Lifearafter/CASE/README.md

# C.A.S.E

Welcome to the Compact Antenna Experimenter System Project repository! This project focuses on providing the necessary code and documentation to create a fully functional and electrically viable CubeSat. In this repository, you will find the software and firmware that drive the electrical components of a CubeSat, ensuring its proper functionality in space.

## Table of Contents

- Introduction
- Getting Started
- Project Structure
- Dependencies
- Contributing
- License

## Introduction

CubeSats are miniaturized satellites that have become increasingly popular for space exploration and scientific research due to their small size, cost-effectiveness, and modular design. This project focuses specifically on the electrical aspects of a CubeSat, excluding any mechanical components.

The key objectives of this project include:

- **Power Management:** Efficiently manage power resources to ensure the CubeSat's continuous operation in space.

- **Communication Systems:** Implement reliable communication protocols for data transmission between the CubeSat and ground control.

- **Sensor Integration:** Integrate and interface various sensors to gather data for scientific or mission-specific purposes.

- **Onboard Computer Systems:** Develop the necessary software for the CubeSat's onboard computer to execute mission tasks and handle data.

- **Fault Tolerance:** Implement mechanisms to handle errors and faults to ensure the CubeSat's robustness in harsh space environments.

## Getting Started

To get started with the CubeSatellite Electrical System Project, follow these steps:

1. **Clone the Repository:**

```
bash
Copy code
git clone https://github.com/your-username/cubesatellite-electrical.git
```

2. **Navigate to the Project Directory:**

```
bash
Copy code
cd cubesatellite-electrical
```

## Explore the Code:

Review the codebase to understand the implementation details and structure.

## Set Up Development Environment:

Follow the instructions in the docs/setup.md document to set up your development environment.

## Contribute:

If you would like to contribute to the project, please follow the guidelines outlined in the Contributing section.

## Project Structure

The project is organized into the following directories:

- src: Contains the source code for the CubeSat's electrical systems.
- docs: Documentation files, including setup instructions and usage guidelines.
- tests: Test cases for ensuring the reliability and functionality of the code.
- inc: Contains all the header files for the project.

## Dependencies

Ensure that you have the following dependencies installed in your development environment:
**Not yet listed**

## License

This project is licensed under the MIT License. Feel free to use, modify, and distribute the code for your CubeSat projects.
