Lifearafter/CASE/docs/FactoryDefaults.md

# Factory Defaults
File to store the factory defaults for all devices used. This file is used as a reference.

## Device 1
### Neo-M8N
* Baudrate: 115200
