Lifearafter/CASE/Schematics/Flight_Computer/FC_PCB.png

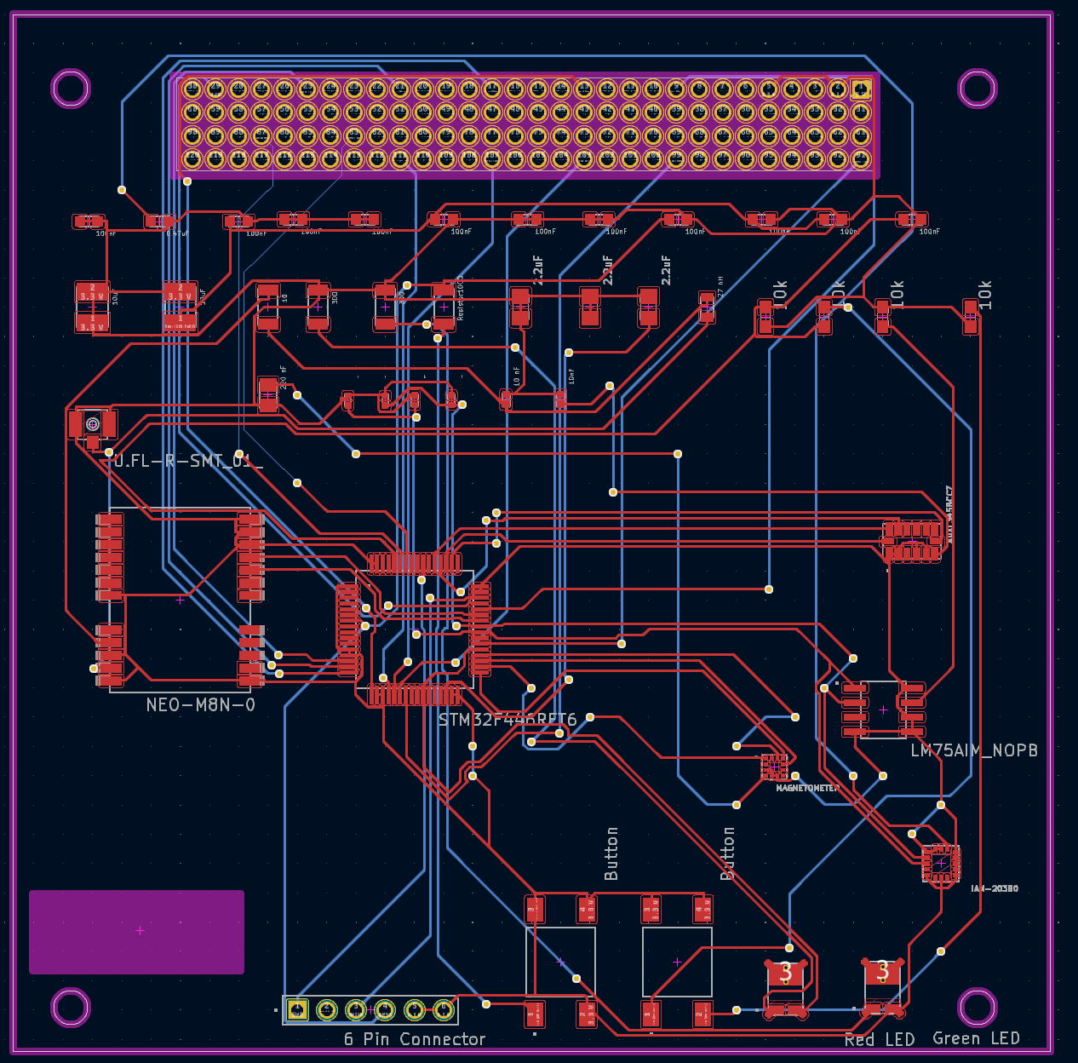
Schematics/Flight_Computer/FC_PCB.png
