Lifearafter/CASE/Schematics/Flight_Computer/FC_PCB_BLUE.png

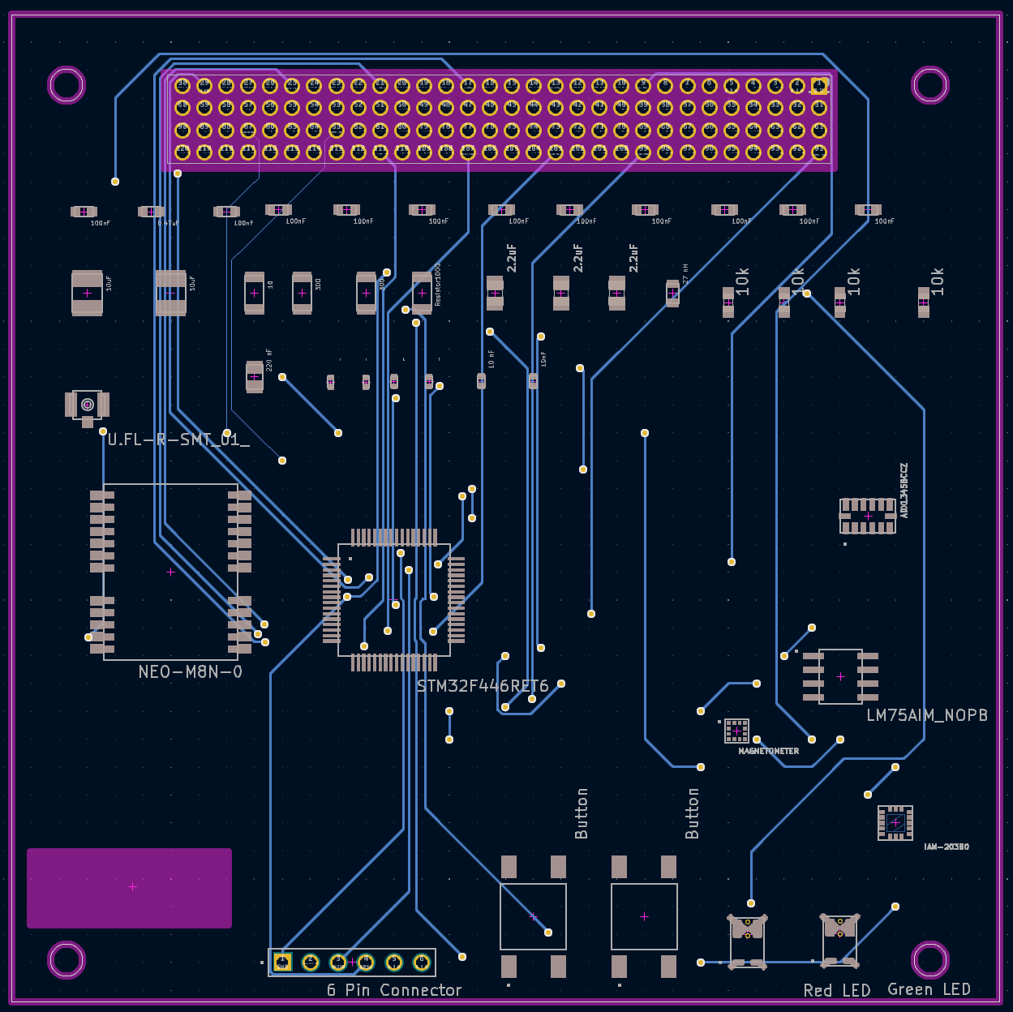
Schematics/Flight_Computer/FC_PCB_BLUE.png
