Lifearafter/CASE/Schematics/Flight_Computer/FC_PCB_RED.png

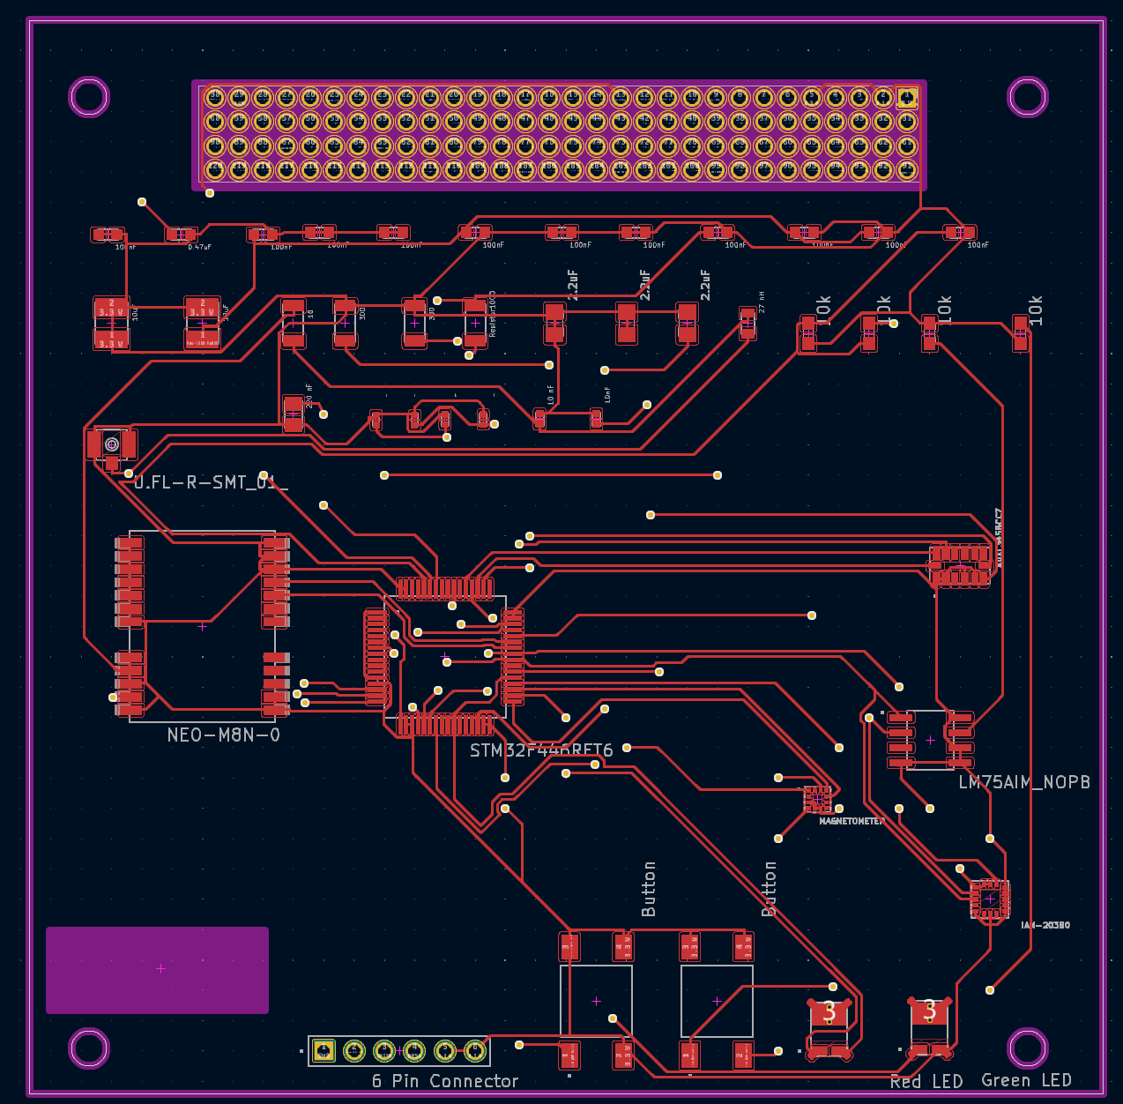
Schematics/Flight_Computer/FC_PCB_RED.png
