Lifearafter/CASE/Schematics/Comms_System/parts_backup/AC0402JRNPO9BN390/3D/AC0402JRNPO9BN390.stp

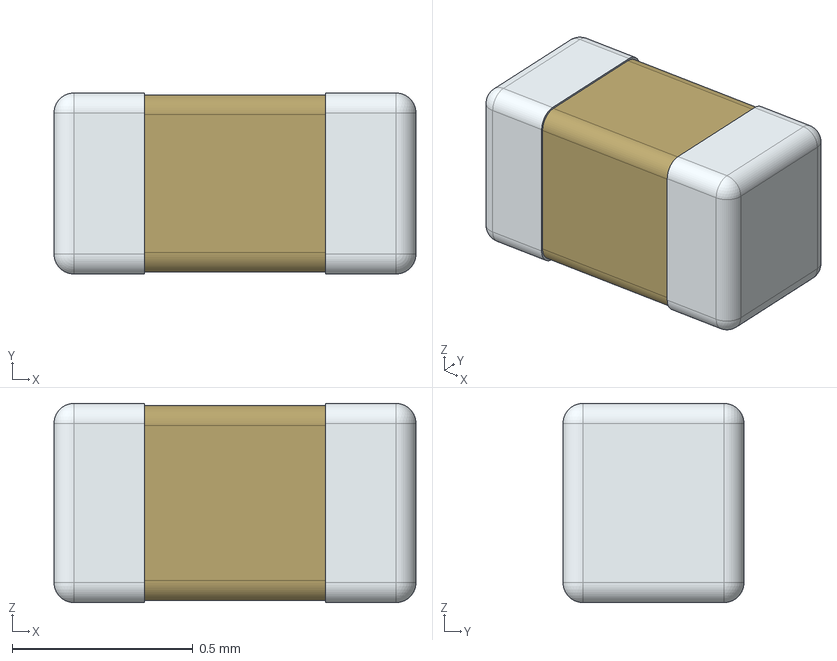
[picture p4: CAD file, 2024-03-26]
Schematics/Comms_System/parts_backup/AC0402JRNPO9BN390/3D/AC0402JRNPO9BN390.stp
1.00 x 0.5 x 0.55 mm
