Lifearafter/CASE/Schematics/Comms_System/parts_backup/C0201C560J3GACTU/3D/C0201C560J3GACTU.stp

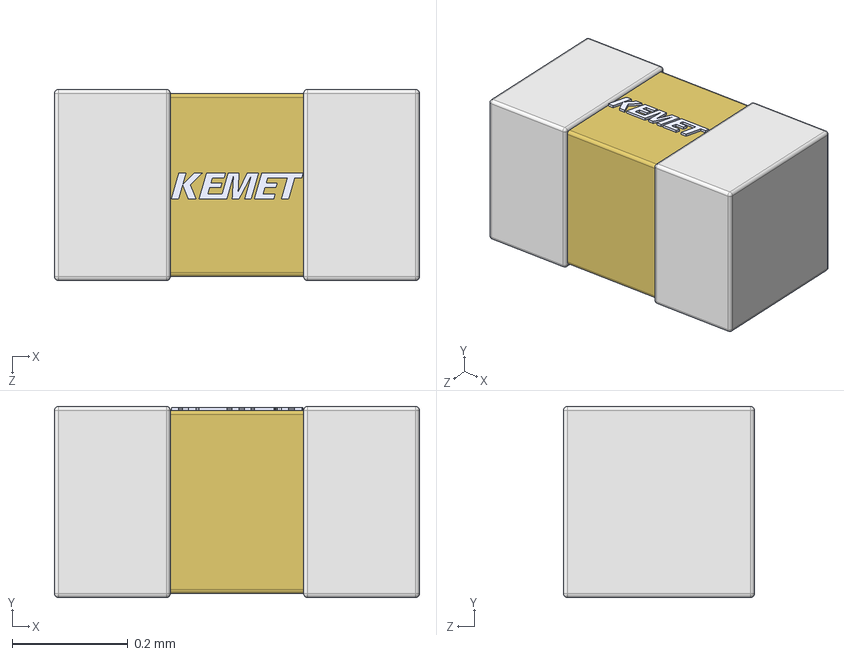
[picture p5: CAD file, 2024-03-26]
Schematics/Comms_System/parts_backup/C0201C560J3GACTU/3D/C0201C560J3GACTU.stp
0.63 x 0.33 x 0.33 mm
