Lifearafter/CASE/Schematics/Comms_System/parts_backup/C0603C200K8HACTU/3D/C0603C200K8HACTU.stp

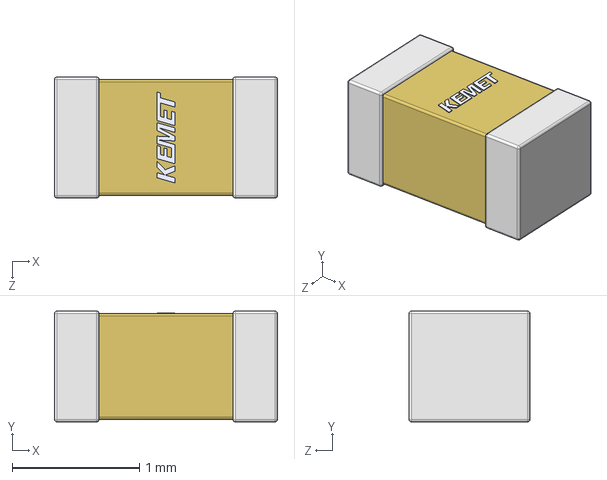
[picture p6: CAD file, 2024-03-26]
Schematics/Comms_System/parts_backup/C0603C200K8HACTU/3D/C0603C200K8HACTU.stp
1.75 x 0.87 x 0.95 mm
