Lifearafter/CASE/Schematics/Comms_System/parts_backup/EMK063AC6104KP-F/3D/EMK063AC6104KP-F.stp

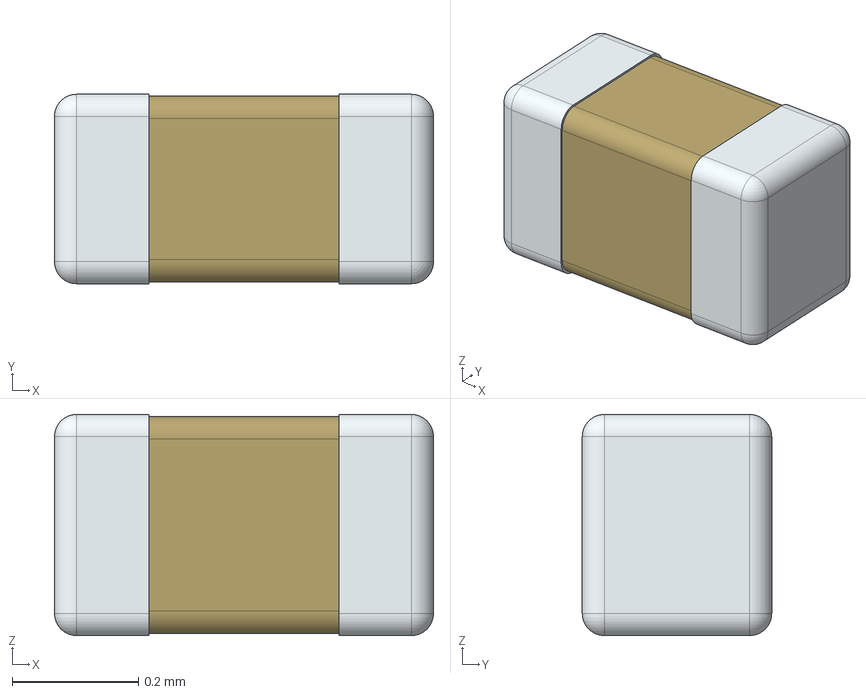
[picture p7: CAD file, 2024-03-26]
Schematics/Comms_System/parts_backup/EMK063AC6104KP-F/3D/EMK063AC6104KP-F.stp
0.6 x 0.3 x 0.35 mm
