Lifearafter/CASE/Schematics/Comms_System/parts_backup/ERA-8VEB5602V/3D/ERA-8VEB5602V.stp

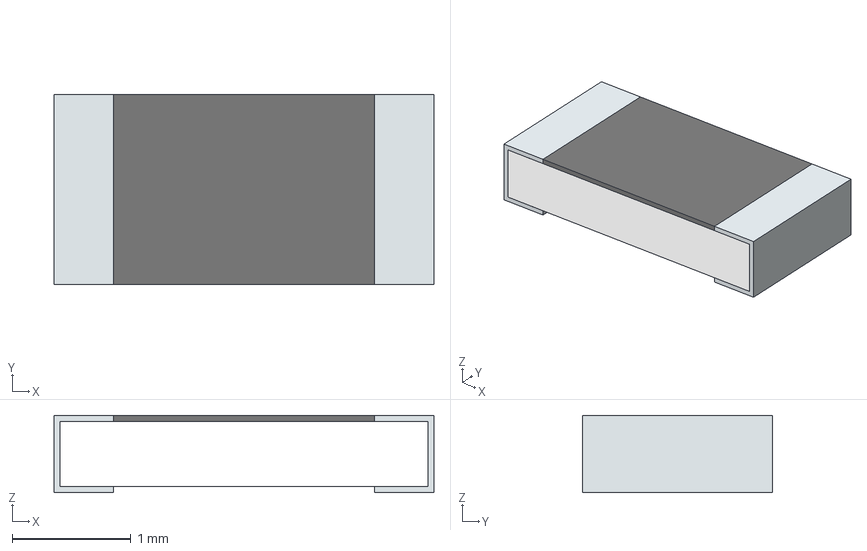
[picture p8: CAD file, 2024-03-26]
Schematics/Comms_System/parts_backup/ERA-8VEB5602V/3D/ERA-8VEB5602V.stp
3.20 x 1.60 x 0.65 mm
solidBody
Terminal
solidLid
