Lifearafter/CASE/Schematics/Comms_System/parts_backup/ERJ-1GJF3301C/3D/ERJ-1GJF3301C.stp

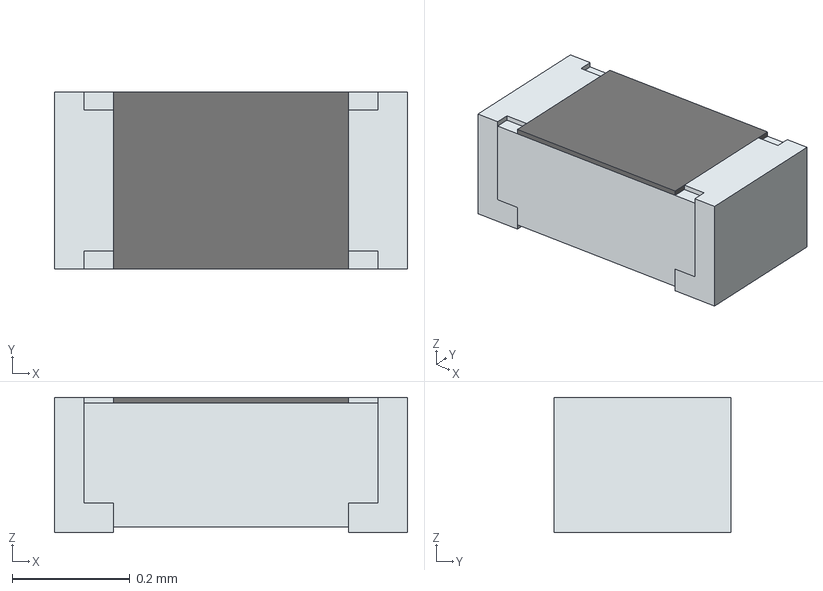
[picture p9: CAD file, 2024-03-26]
Schematics/Comms_System/parts_backup/ERJ-1GJF3301C/3D/ERJ-1GJF3301C.stp
0.6 x 0.3 x 0.23 mm
solidBody
Terminal
solidTop
