Lifearafter/CASE/Schematics/Comms_System/parts_backup/ERJ-XGNJ180Y/3D/ERJ-XGNJ180Y.stp

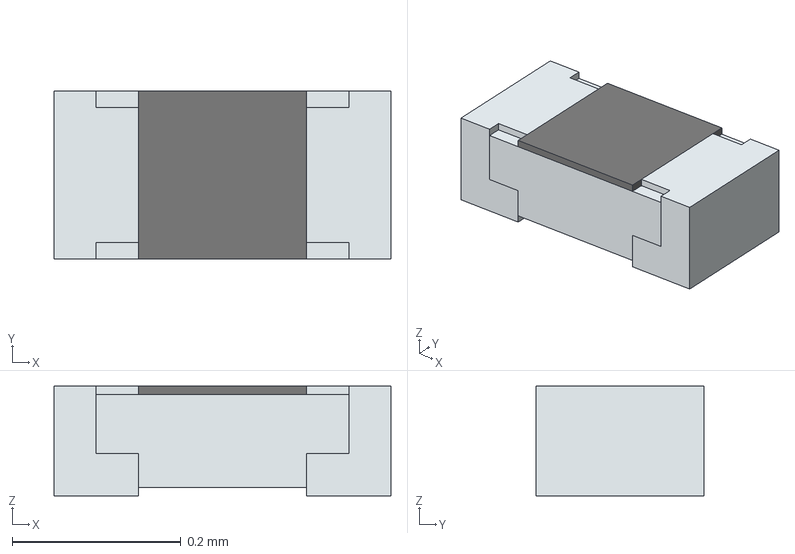
[picture p10: CAD file, 2024-03-26]
Schematics/Comms_System/parts_backup/ERJ-XGNJ180Y/3D/ERJ-XGNJ180Y.stp
0.4 x 0.2 x 0.13 mm
solidBody
Terminal
solidTop
