Lifearafter/CASE/Schematics/Comms_System/parts_backup/GCD188R71H392KA01J/3D/GCD188R71H392KA01J.stp

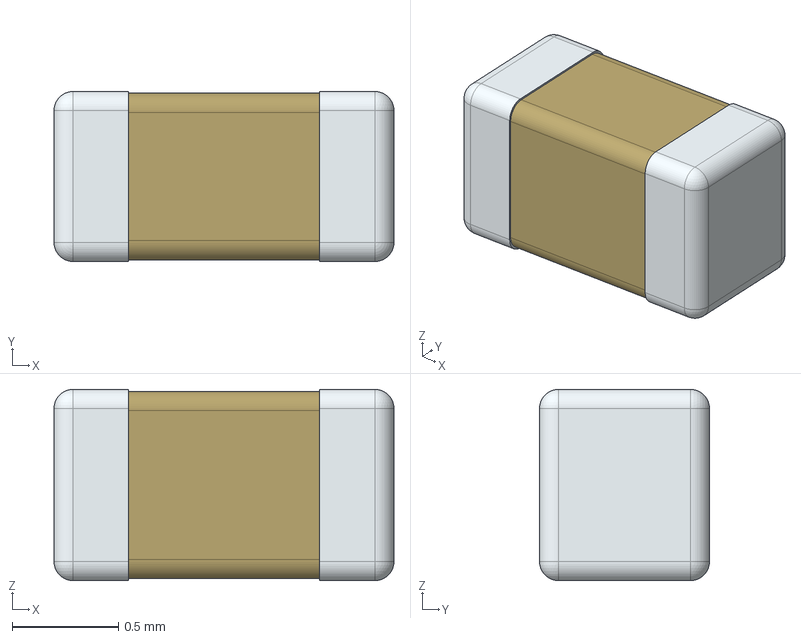
[picture p11: CAD file, 2024-03-26]
Schematics/Comms_System/parts_backup/GCD188R71H392KA01J/3D/GCD188R71H392KA01J.stp
1.60 x 0.8 x 0.9 mm
