Lifearafter/CASE/Schematics/Comms_System/parts_backup/GRM0335C1H4R3WA01D/3D/GRM0335C1H4R3WA01D.stp

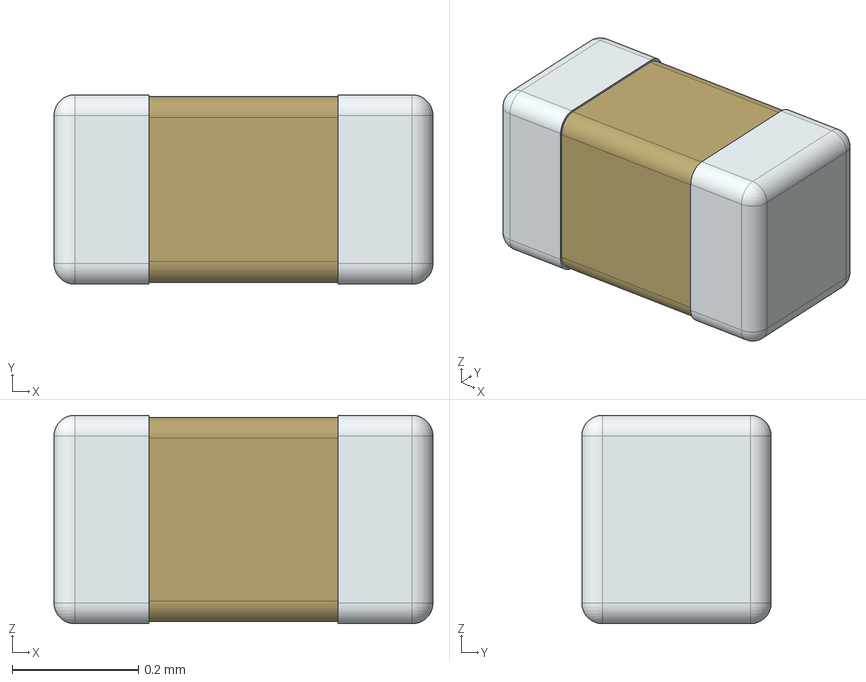
[picture p12: CAD file, 2024-03-26]
Schematics/Comms_System/parts_backup/GRM0335C1H4R3WA01D/3D/GRM0335C1H4R3WA01D.stp
0.6 x 0.3 x 0.33 mm
