Lifearafter/CASE/Schematics/Comms_System/parts_backup/GRM1885C1H512JA01D/3D/GRM1885C1H512JA01D.stp

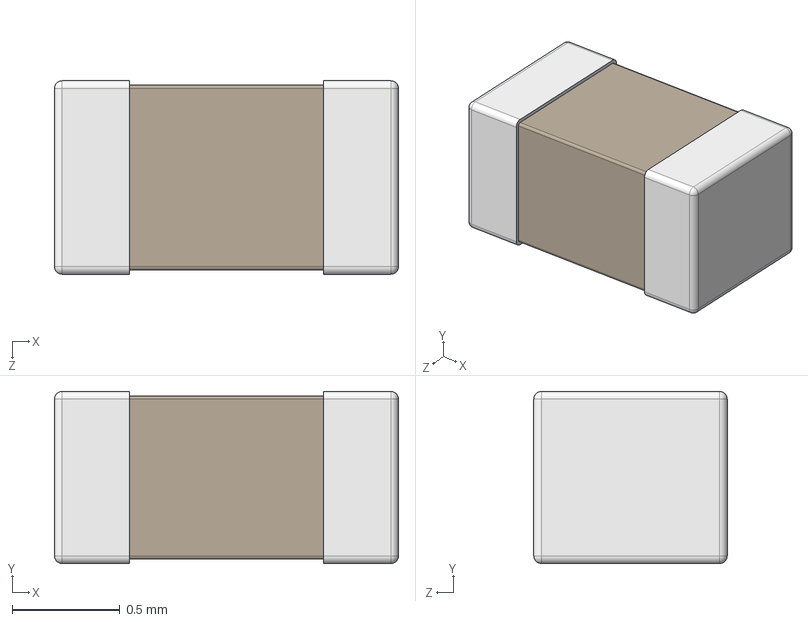
[picture p13: CAD file, 2024-03-26]
Schematics/Comms_System/parts_backup/GRM1885C1H512JA01D/3D/GRM1885C1H512JA01D.stp
1.60 x 0.8 x 0.9 mm
