Lifearafter/CASE/Schematics/Comms_System/parts_backup/LQG15HH22NJ02D/3D/LQG15HH22NJ02D.stp

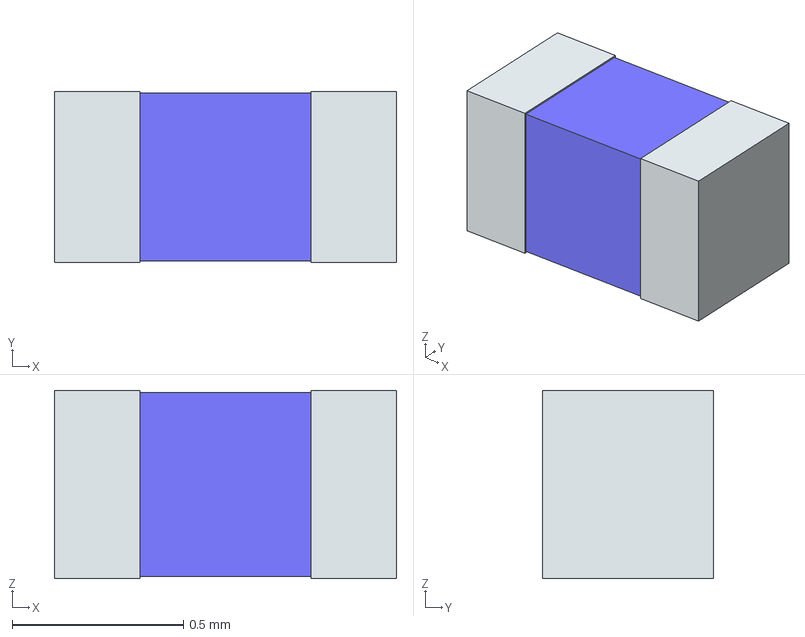
[picture p14: CAD file, 2024-03-26]
Schematics/Comms_System/parts_backup/LQG15HH22NJ02D/3D/LQG15HH22NJ02D.stp
1.00 x 0.5 x 0.55 mm
term1
term2
