Lifearafter/CASE/Schematics/Comms_System/parts_backup/LQG15WH3N0B02D/3D/LQG15WH3N0B02D.stp

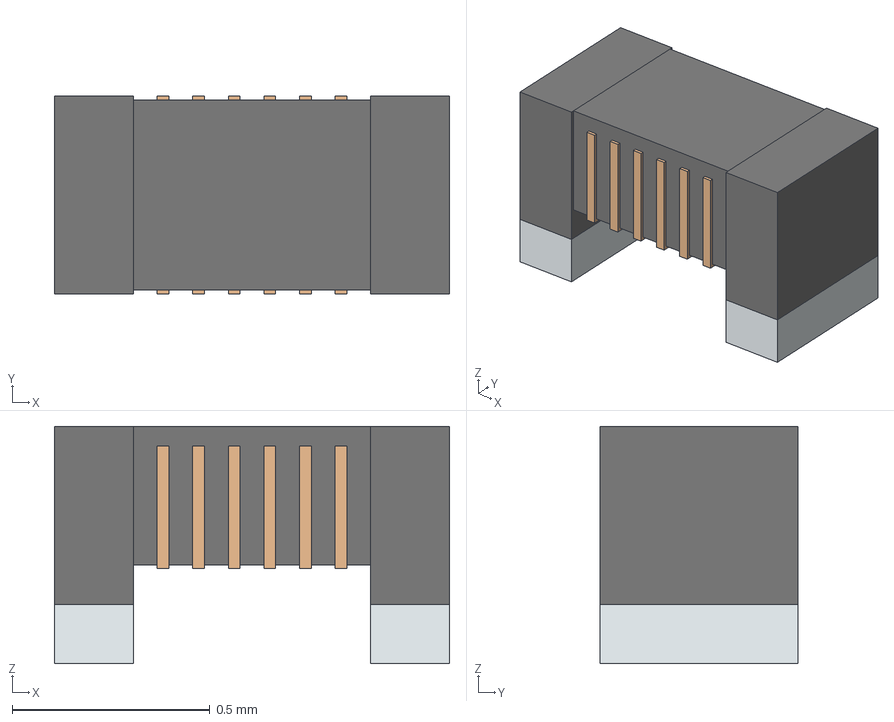
[picture p15: CAD file, 2024-03-26]
Schematics/Comms_System/parts_backup/LQG15WH3N0B02D/3D/LQG15WH3N0B02D.stp
1.00 x 0.5 x 0.6 mm
Rect1
Rect2
Rect3
Rect4
Rect5
Rect6
Rect7
Rect8
Rect9
Rect10
Rect11
