Lifearafter/CASE/Schematics/Comms_System/parts_backup/LQW18AN43NJ0ZD/3D/LQW18AN43NJ0ZD.stp

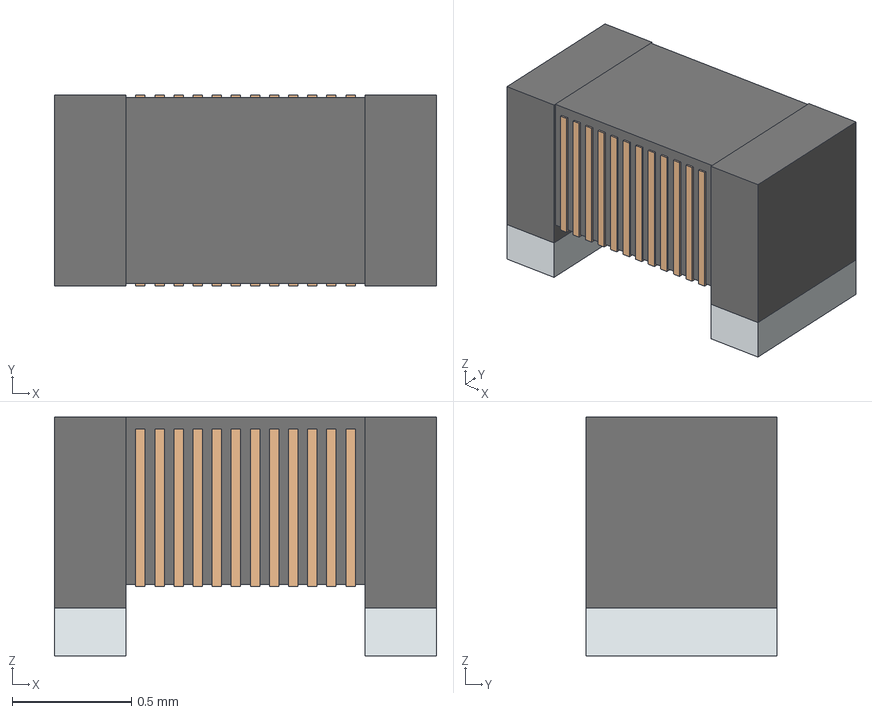
[picture p16: CAD file, 2024-03-26]
Schematics/Comms_System/parts_backup/LQW18AN43NJ0ZD/3D/LQW18AN43NJ0ZD.stp
1.60 x 0.8 x 1.00 mm
Rect1
Rect2
Rect3
Rect4
Rect5
Rect6
Rect7
Rect8
Rect9
Rect10
Rect11
Rect12
Rect13
Rect14
Rect15
Rect16
Rect17
