Lifearafter/CASE/Schematics/Comms_System/parts_backup/MLG1005S5N6ST000/3D/MLG1005S5N6ST000.stp

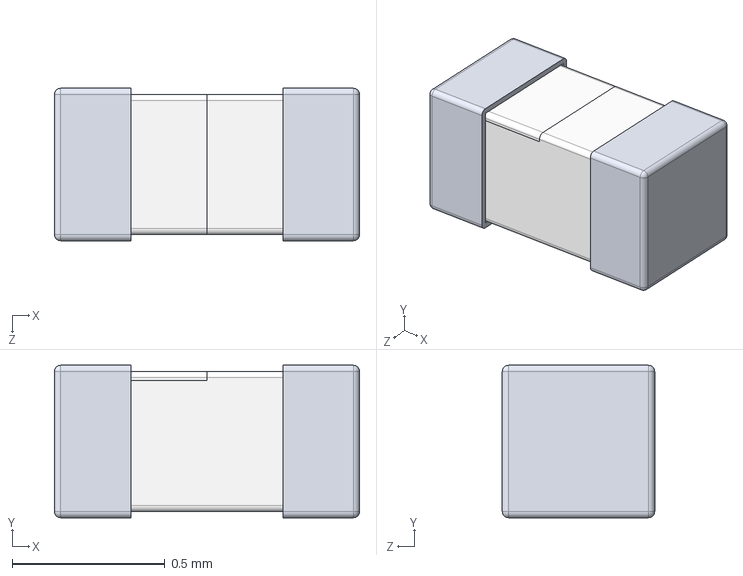
[picture p17: CAD file, 2024-03-26]
Schematics/Comms_System/parts_backup/MLG1005S5N6ST000/3D/MLG1005S5N6ST000.stp
1.00 x 0.5 x 0.5 mm
