Lifearafter/CASE/Schematics/Comms_System/parts_backup/SBTC-2-10LX+/3D/SBTC-2-10LX+.stp

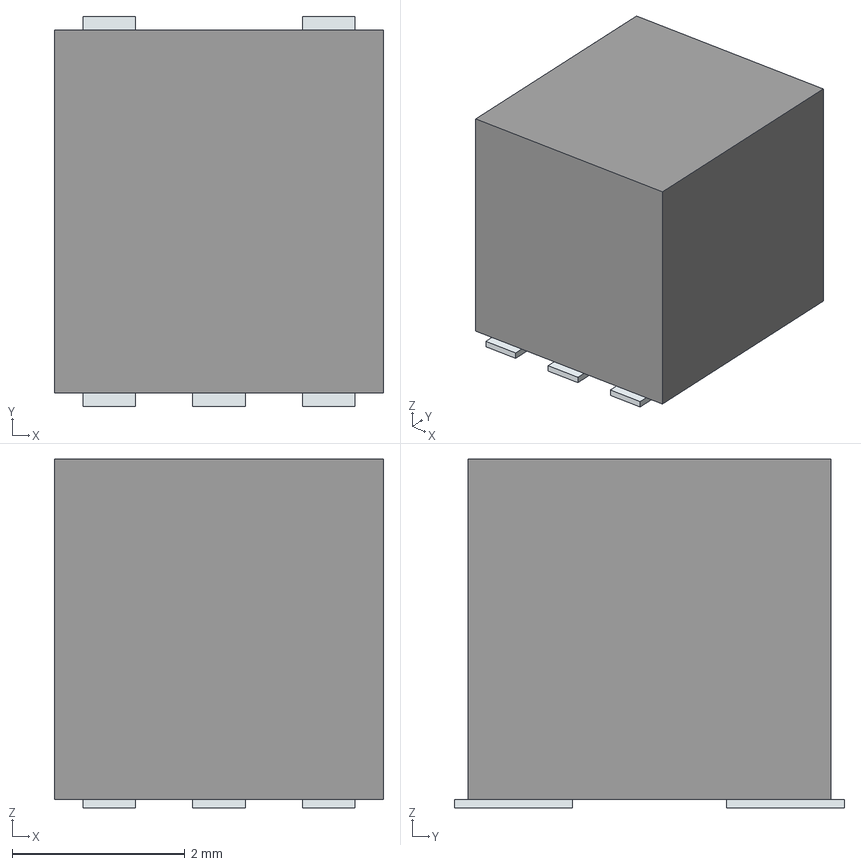
[picture p18: CAD file, 2024-03-26]
Schematics/Comms_System/parts_backup/SBTC-2-10LX+/3D/SBTC-2-10LX+.stp
3.81 x 4.52 x 4.04 mm
Pins
