Lifearafter/CASE/Schematics/Comms_System/parts_backup/TG2520SMN_32.0000M-ECGNNM0/3D/TG2520SMN_32.0000M-ECGNNM0.stp

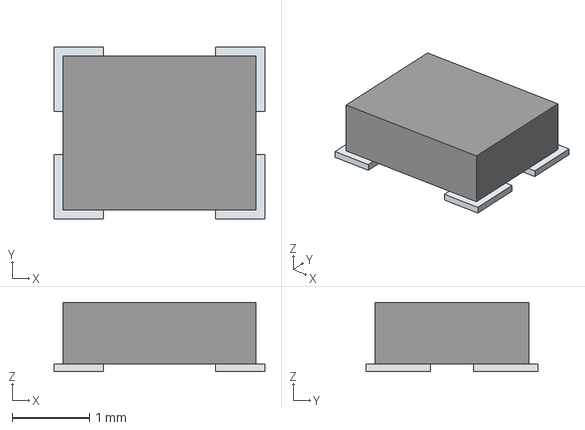
[picture p19: CAD file, 2024-03-26]
Schematics/Comms_System/parts_backup/TG2520SMN_32.0000M-ECGNNM0/3D/TG2520SMN_32.0000M-ECGNNM0.stp
2.74 x 2.24 x 0.9 mm
Pins
