Lifearafter/CASE/Schematics/Flight_Computer/CUBESAT/imported files/6 Pin Connector/6 Pin Connector.step

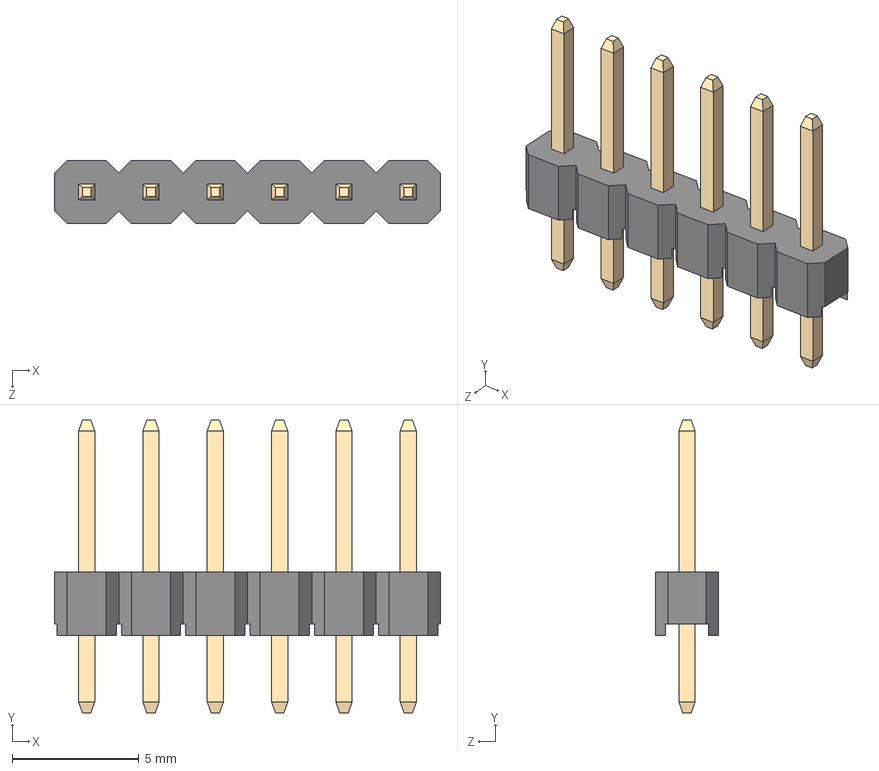
[picture p20: CAD file, 2024-03-28]
Schematics/Flight_Computer/CUBESAT/imported files/6 Pin Connector/6 Pin Connector.step
15.2 x 11.6 x 2.50 mm
