Lifearafter/CASE/Schematics/Flight_Computer/CUBESAT/imported files/Accelerometer/Accelerometer.step

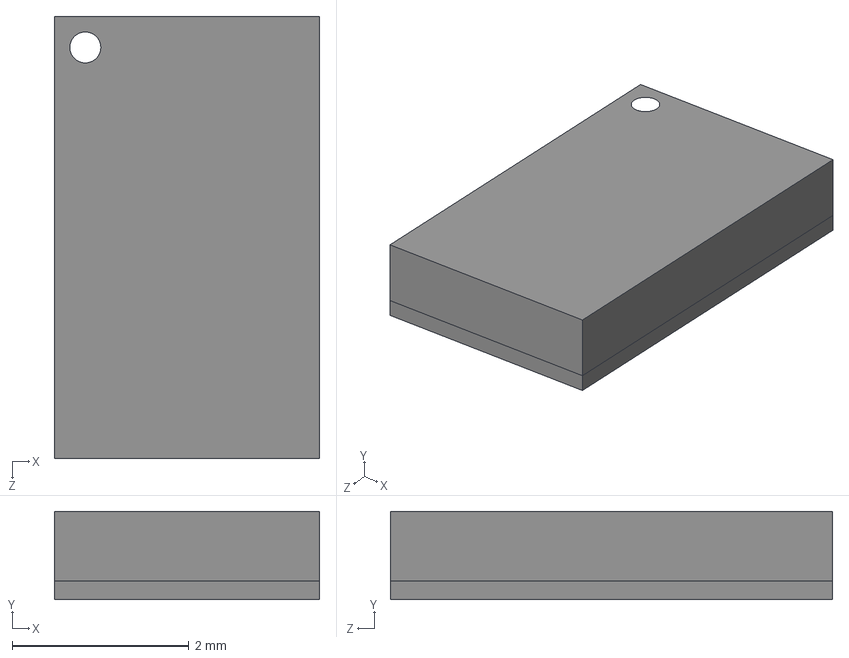
[picture p21: CAD file, 2024-03-26]
Schematics/Flight_Computer/CUBESAT/imported files/Accelerometer/Accelerometer.step
3.00 x 1.00 x 5.00 mm
