Lifearafter/CASE/Schematics/Flight_Computer/CUBESAT/imported files/Capacitors/Capacitor0-47uf/Capacitor0-47uf.step

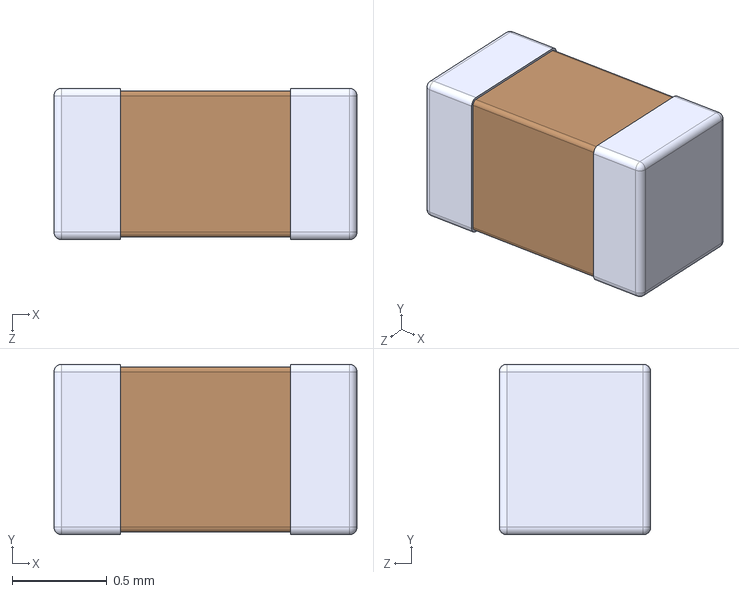
[picture p22: CAD file, 2024-03-26]
Schematics/Flight_Computer/CUBESAT/imported files/Capacitors/Capacitor0-47uf/Capacitor0-47uf.step
1.60 x 0.9 x 0.8 mm
