Lifearafter/CASE/Schematics/Flight_Computer/CUBESAT/imported files/Capacitors/Capacitor10nf/Capacitor10nf.step

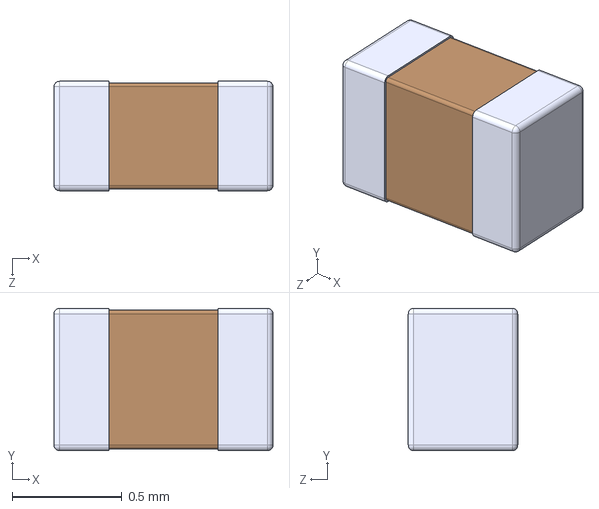
[picture p23: CAD file, 2024-03-26]
Schematics/Flight_Computer/CUBESAT/imported files/Capacitors/Capacitor10nf/Capacitor10nf.step
1.00 x 0.65 x 0.5 mm
