Lifearafter/CASE/Schematics/Flight_Computer/CUBESAT/imported files/Capacitors/Capacitor10uf/Capacitor10uf.step

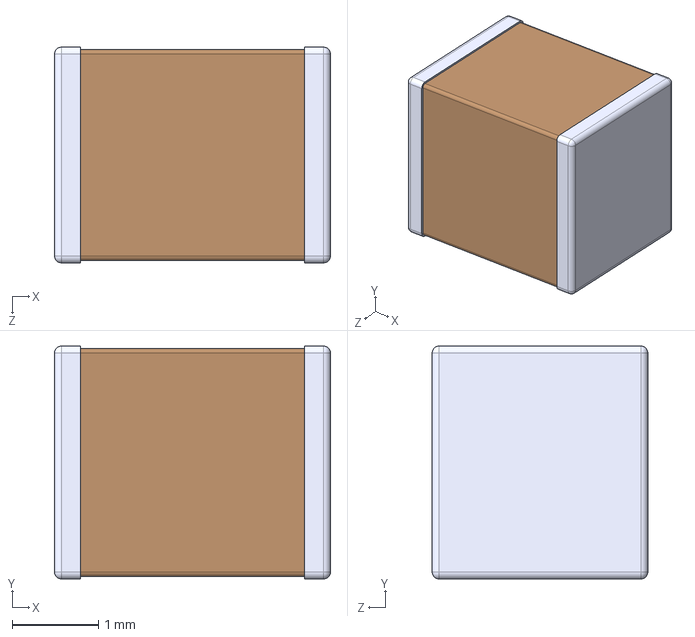
[picture p24: CAD file, 2024-03-26]
Schematics/Flight_Computer/CUBESAT/imported files/Capacitors/Capacitor10uf/Capacitor10uf.step
3.20 x 2.70 x 2.50 mm
