Lifearafter/CASE/Schematics/Flight_Computer/CUBESAT/imported files/Capacitors/Capacitor2-2uf/Capacitor2-2uf.step

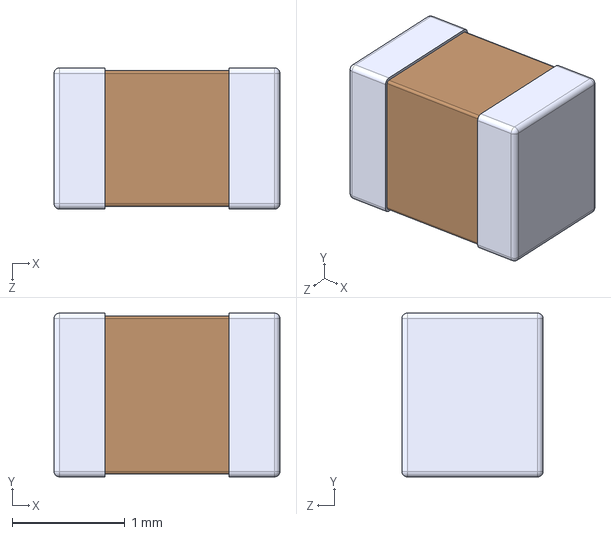
[picture p25: CAD file, 2024-03-26]
Schematics/Flight_Computer/CUBESAT/imported files/Capacitors/Capacitor2-2uf/Capacitor2-2uf.step
2.00 x 1.45 x 1.25 mm
