Lifearafter/CASE/Schematics/Flight_Computer/CUBESAT/imported files/GPS/GPS.step

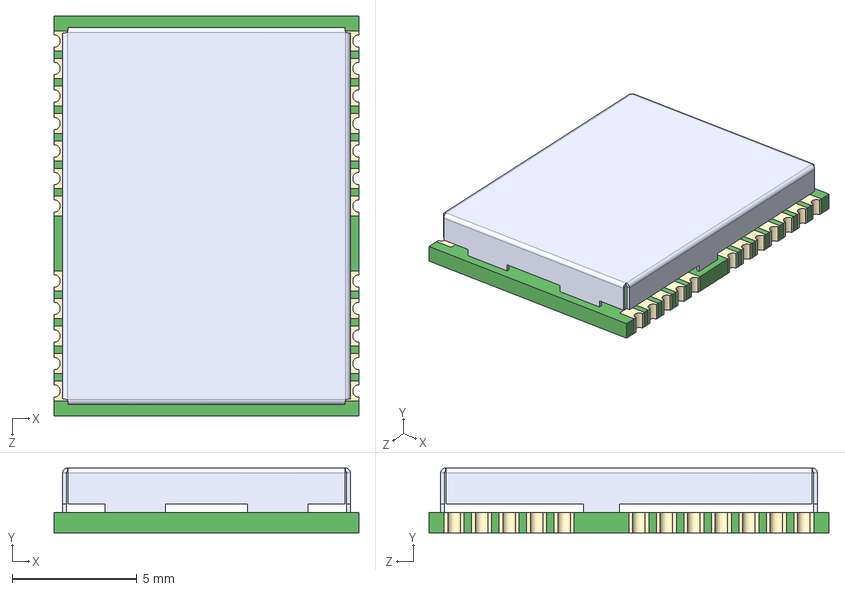
[picture p26: CAD file, 2024-03-26]
Schematics/Flight_Computer/CUBESAT/imported files/GPS/GPS.step
12.2 x 2.60 x 16.0 mm
