Lifearafter/CASE/Schematics/Flight_Computer/CUBESAT/imported files/Gyroscope/Gyroscope.step

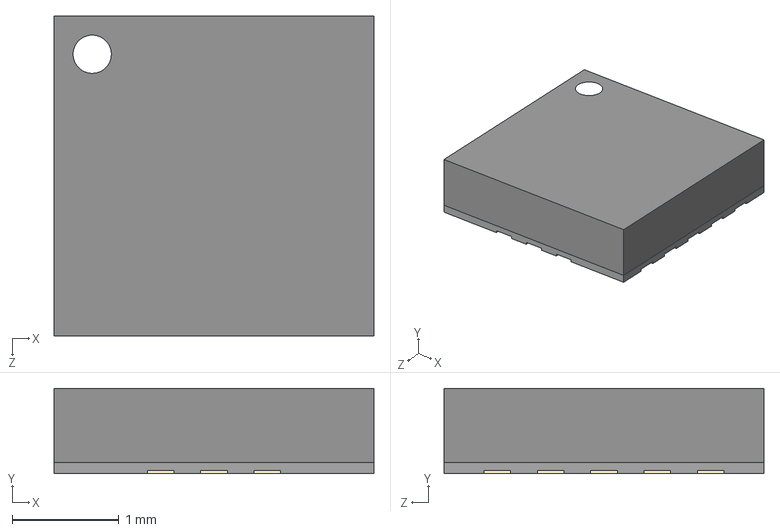
[picture p27: CAD file, 2024-03-26]
Schematics/Flight_Computer/CUBESAT/imported files/Gyroscope/Gyroscope.step
3.00 x 0.8 x 3.00 mm
