Lifearafter/CASE/Schematics/Flight_Computer/CUBESAT/imported files/Inductors/Inductor27nH/Inductor27nH.step

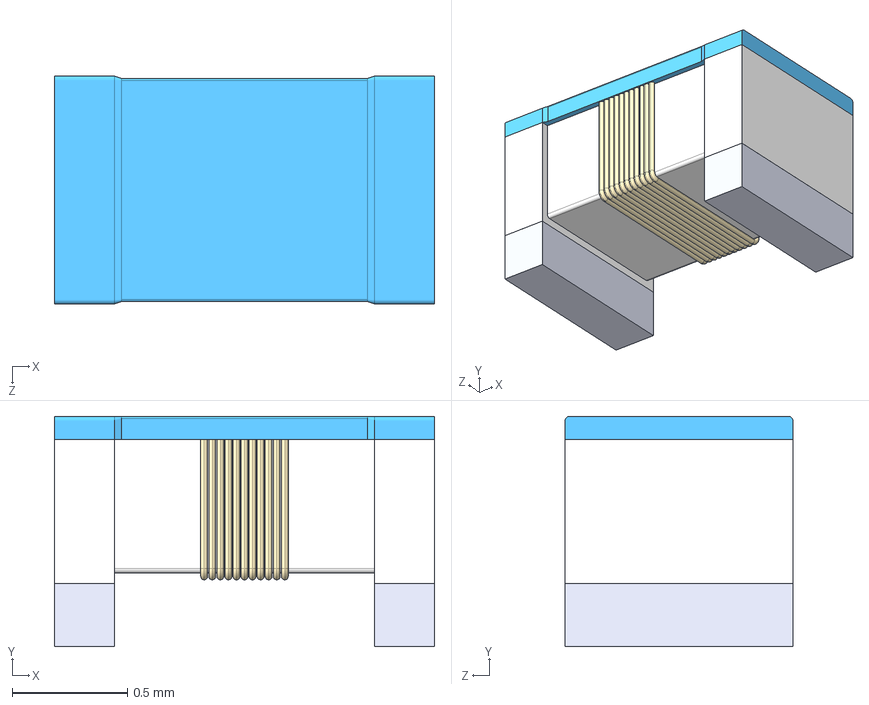
[picture p28: CAD file, 2024-03-26]
Schematics/Flight_Computer/CUBESAT/imported files/Inductors/Inductor27nH/Inductor27nH.step
1.65 x 1.00 x 0.99 mm
