Lifearafter/CASE/Schematics/Flight_Computer/CUBESAT/imported files/MAGNETOMETER/MAGNETOMETER.step

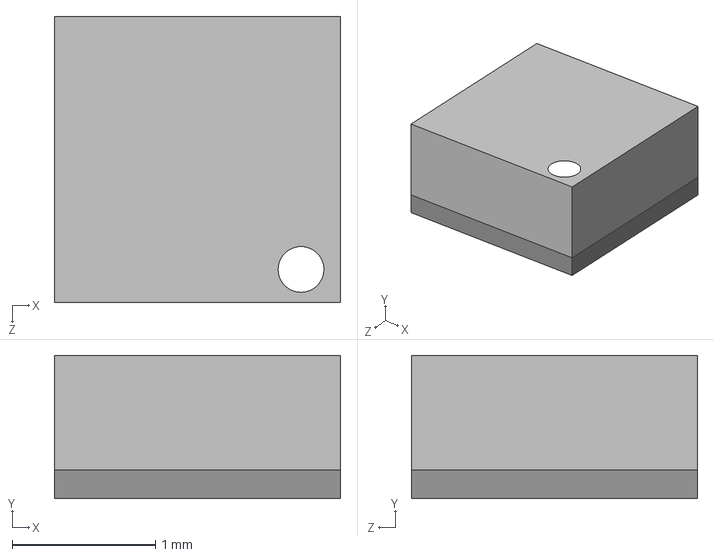
[picture p29: CAD file, 2024-03-26]
Schematics/Flight_Computer/CUBESAT/imported files/MAGNETOMETER/MAGNETOMETER.step
2.00 x 1.00 x 2.00 mm
