Lifearafter/CASE/Schematics/Flight_Computer/CUBESAT/imported files/Powcur/Powcur.step

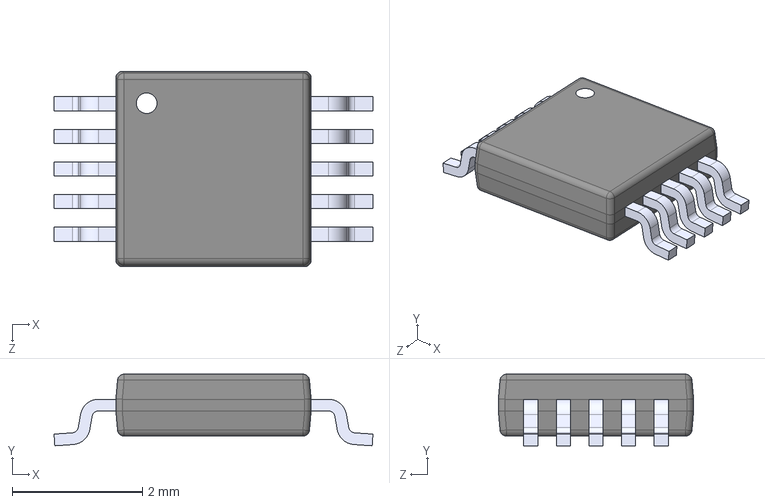
[picture p30: CAD file, 2024-03-26]
Schematics/Flight_Computer/CUBESAT/imported files/Powcur/Powcur.step
4.90 x 1.10 x 3.00 mm
