Lifearafter/CASE/Schematics/Flight_Computer/CUBESAT/imported files/Resistors/Reistor100O/Reistor100O.step

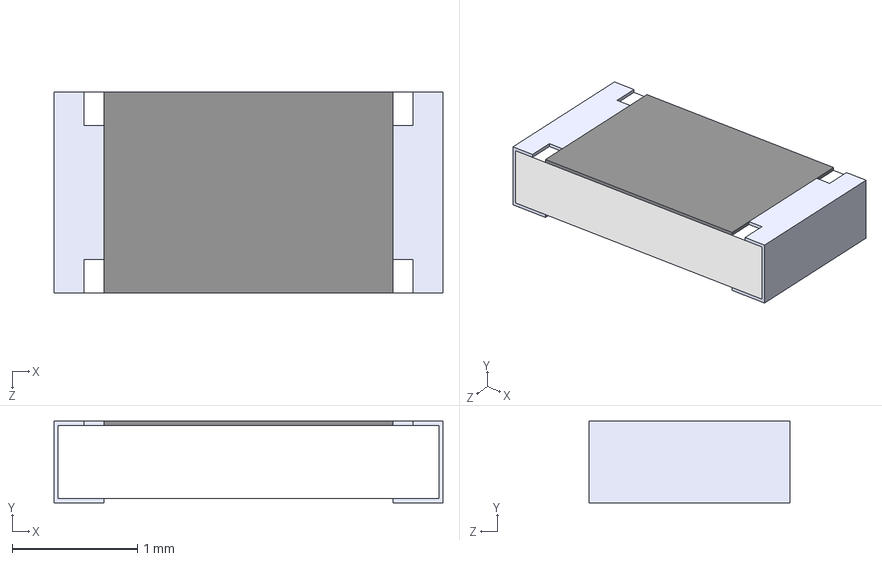
[picture p31: CAD file, 2024-03-26]
Schematics/Flight_Computer/CUBESAT/imported files/Resistors/Reistor100O/Reistor100O.step
3.10 x 0.65 x 1.60 mm
