Lifearafter/CASE/Schematics/Flight_Computer/CUBESAT/imported files/Resistors/Resistor10kO/Resistor10kO.step

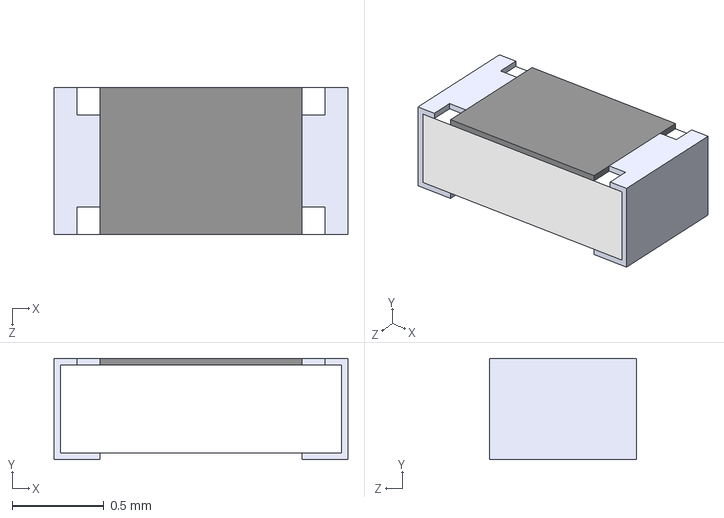
[picture p32: CAD file, 2024-03-26]
Schematics/Flight_Computer/CUBESAT/imported files/Resistors/Resistor10kO/Resistor10kO.step
1.60 x 0.55 x 0.8 mm
