Lifearafter/CASE/Schematics/Flight_Computer/CUBESAT/imported files/Resistors/Resistor4.7kO/Resistor4.7kO.step

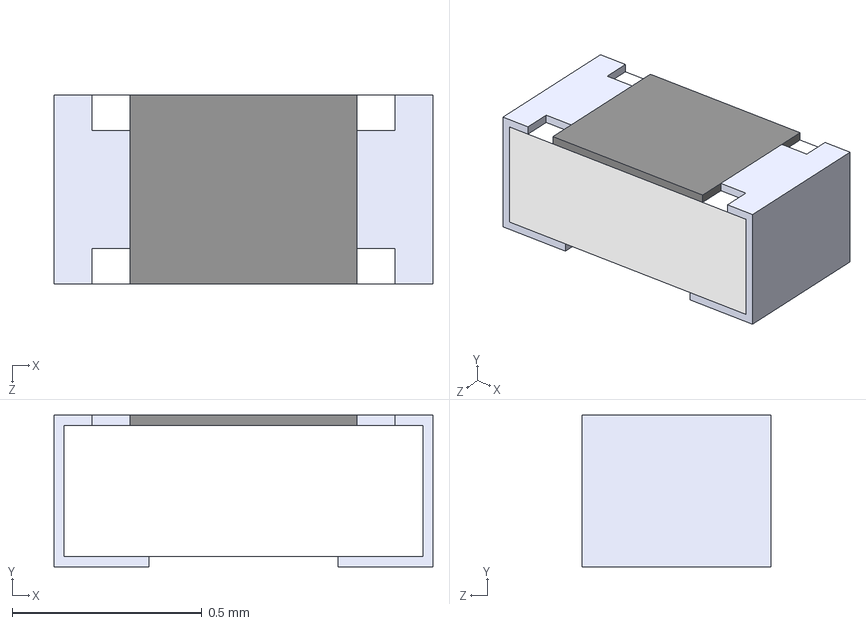
[picture p33: CAD file, 2024-03-28]
Schematics/Flight_Computer/CUBESAT/imported files/Resistors/Resistor4.7kO/Resistor4.7kO.step
1.00 x 0.4 x 0.5 mm
