Lifearafter/CASE/Schematics/Flight_Computer/CUBESAT/imported files/STM32/STM32.step

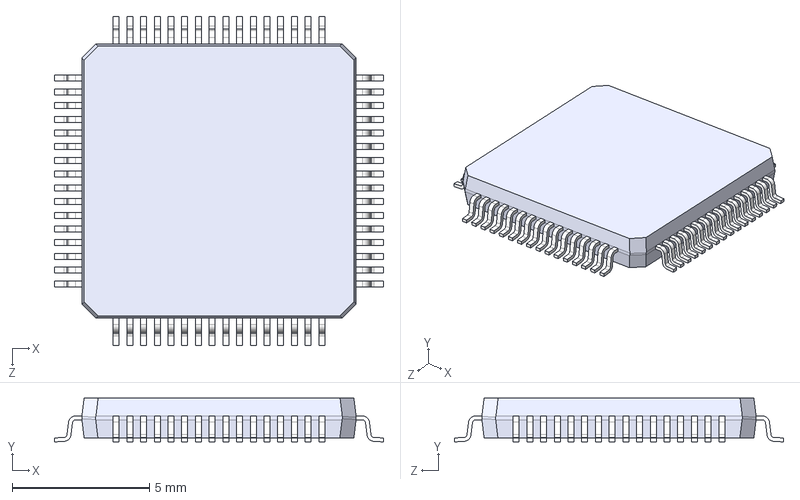
[picture p34: CAD file, 2024-03-26]
Schematics/Flight_Computer/CUBESAT/imported files/STM32/STM32.step
12.0 x 1.60 x 12.0 mm
