Lifearafter/CASE/Schematics/Flight_Computer/CUBESAT/imported files/Temp/Temp.step

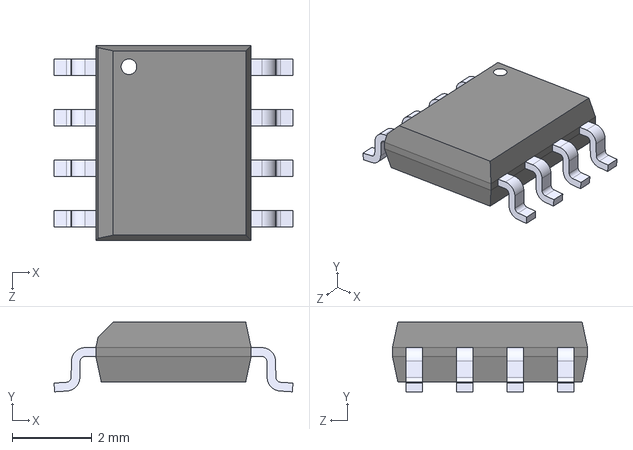
[picture p35: CAD file, 2024-03-26]
Schematics/Flight_Computer/CUBESAT/imported files/Temp/Temp.step
6.00 x 1.75 x 4.90 mm
