Lifearafter/CASE/Schematics/Flight_Computer/CUBESAT/imported files/UFL/UFL.step

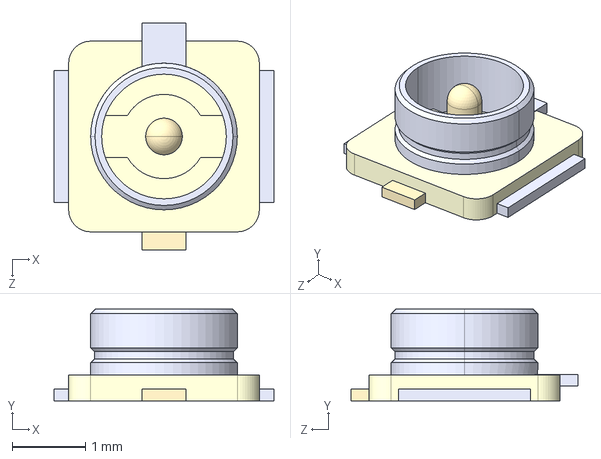
[picture p36: CAD file, 2024-03-26]
Schematics/Flight_Computer/CUBESAT/imported files/UFL/UFL.step
3.00 x 1.25 x 3.10 mm
