Lifearafter/CASE/(list of files, cad)

Other CAD files:
Schematics/Comms_System/parts_backup/C0402C103K1RACAUTO/3D/C0402C103K1RACAUTO.stp
Schematics/Comms_System/parts_backup/GJM1555C1H2R2CB01D/3D/GJM1555C1H2R2CB01D.stp
Schematics/Comms_System/parts_backup/GRM0335C1H5R1DA01D/3D/GRM0335C1H5R1DA01D.stp
Schematics/Comms_System/parts_backup/GRM0335C1H6R2DA01D/3D/GRM0335C1H6R2DA01D.stp
Schematics/Comms_System/parts_backup/GRM033C80J273KE01D/3D/GRM033C80J273KE01D.stp
Schematics/Comms_System/parts_backup/GRM033R61A103JA01D/3D/GRM033R61A103JA01D.stp
Schematics/Comms_System/parts_backup/GRM033R71C101JA01D/3D/GRM033R71C101JA01D.stp
Schematics/Comms_System/parts_backup/GRM155R61C473JA01J/3D/GRM155R61C473JA01J.stp
Schematics/Comms_System/parts_backup/GRT0335C1ER22WA02D/3D/GRT0335C1ER22WA02D.stp
Schematics/Comms_System/parts_backup/GRT033R61A224KE01D/3D/GRT033R61A224KE01D.stp
Schematics/Comms_System/parts_backup/LQP03TN15NH02D/3D/LQP03TN15NH02D.stp
Schematics/Comms_System/parts_backup/B82496C3829J/3D/B82496C3829J.stp
