Lifearafter/CASE/Schematics/Comms_System/Schematic_Plots/Comms_system_backup.pdf

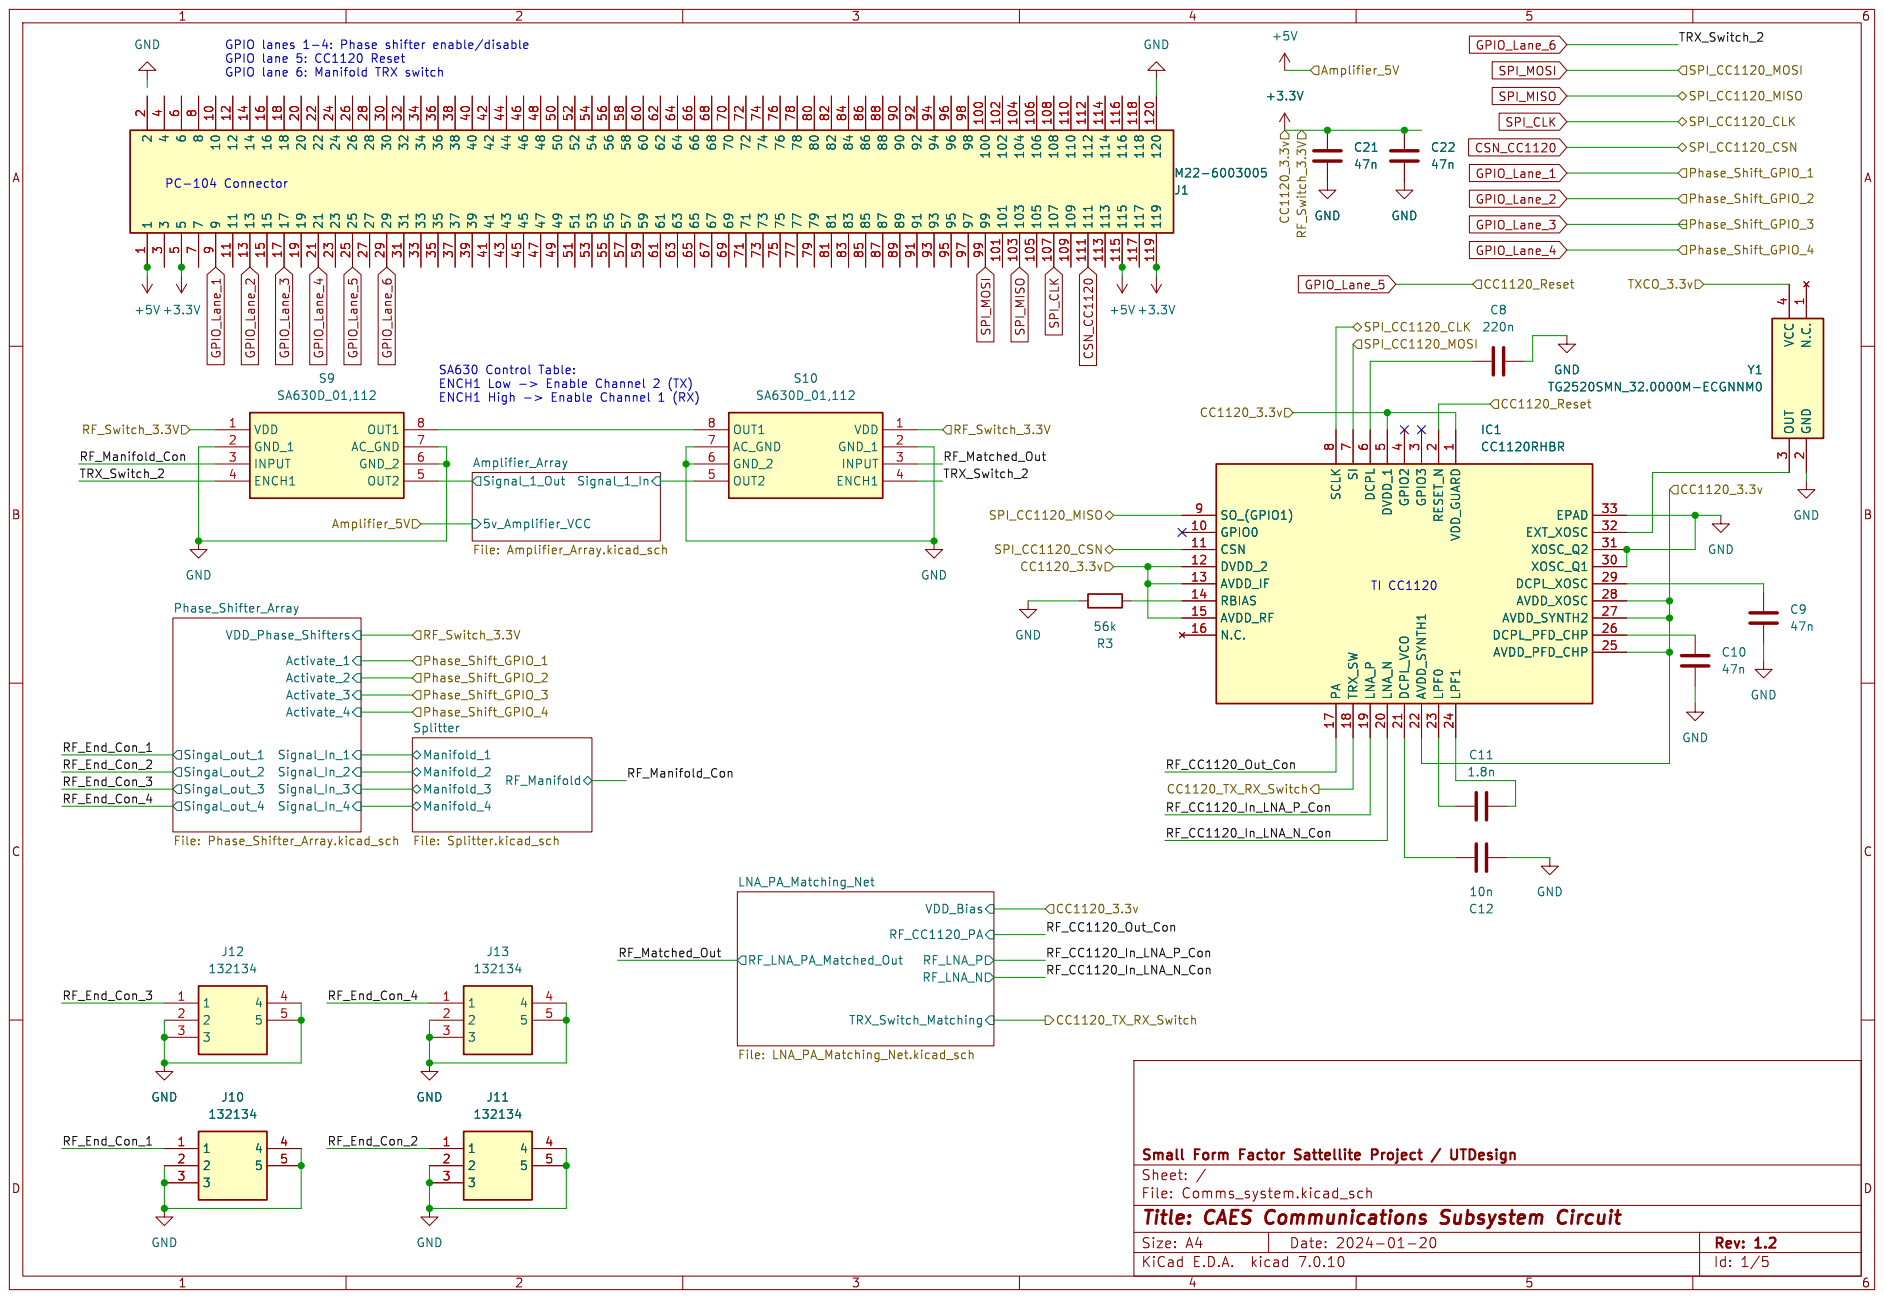
[picture p37: page 1]

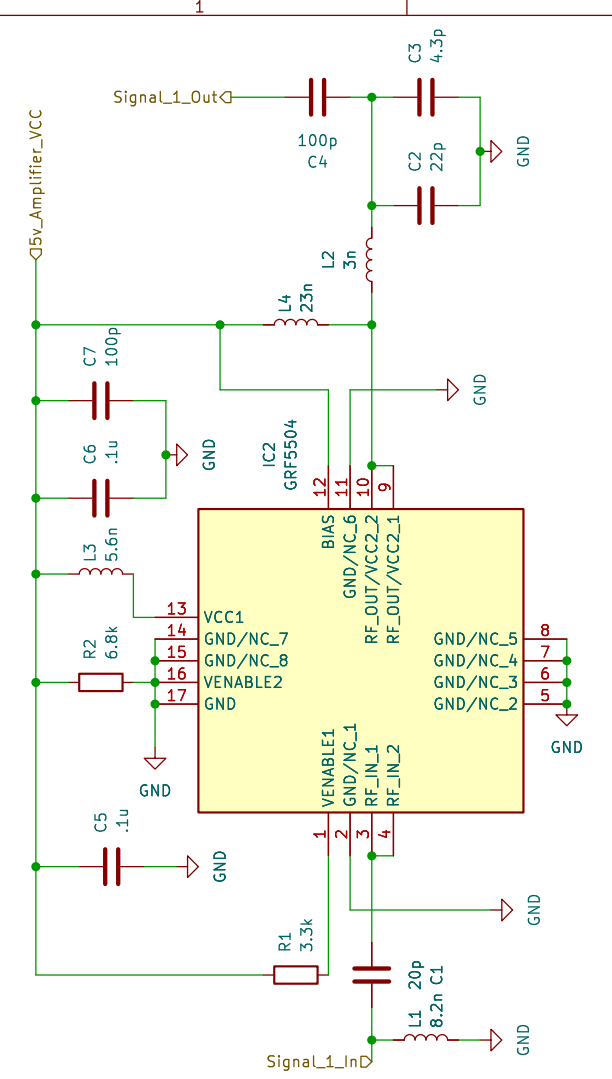
[picture p38: page 2]

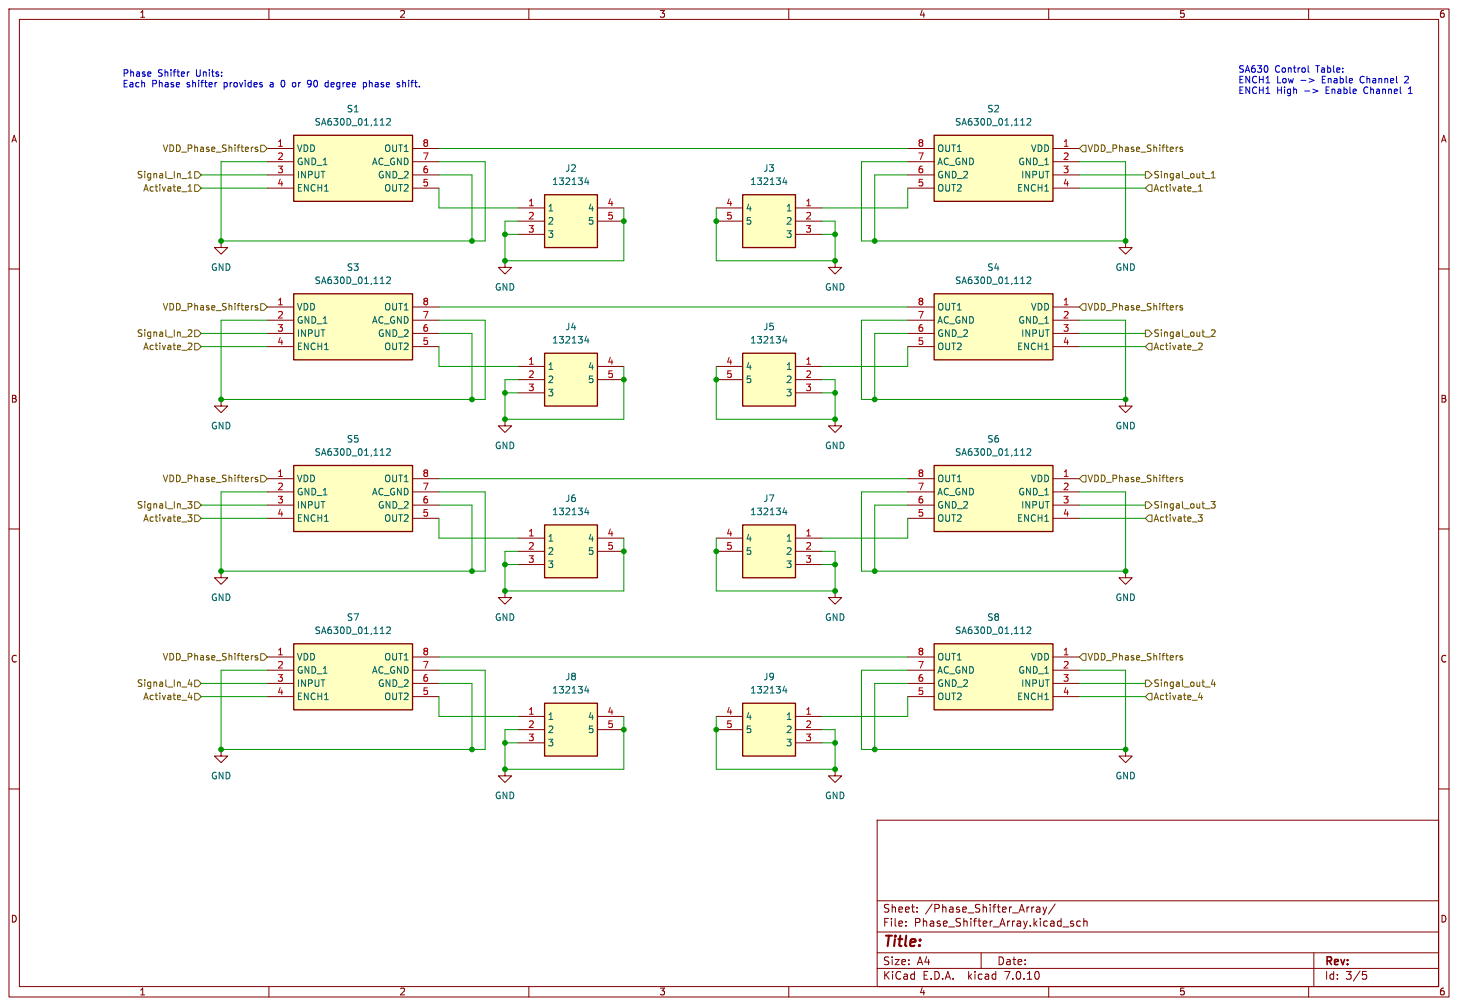
[picture p39: page 3]

Id: 3/5 Title: File: Phase_Shifter_Array.kicad_sch Sheet: /Phase_Shifter_Array/ GND

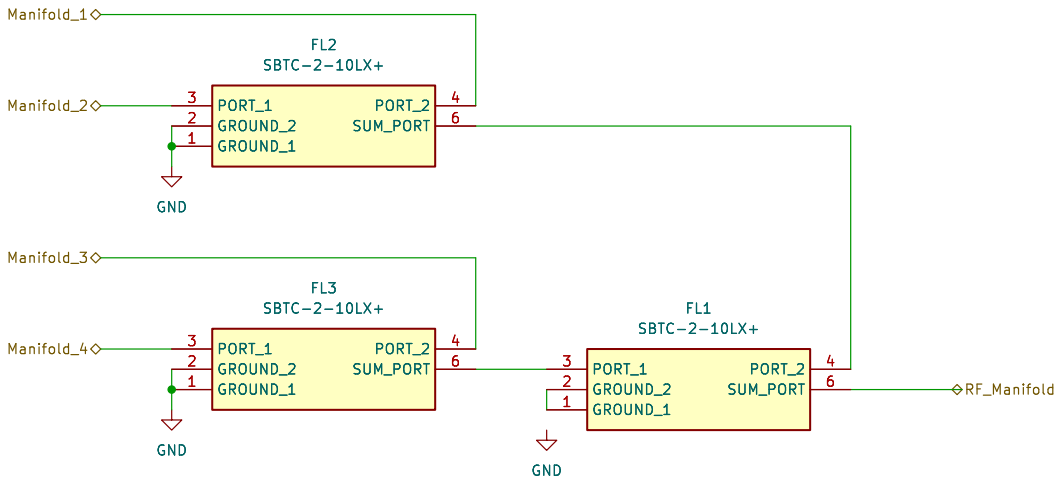
[picture p40: page 4]

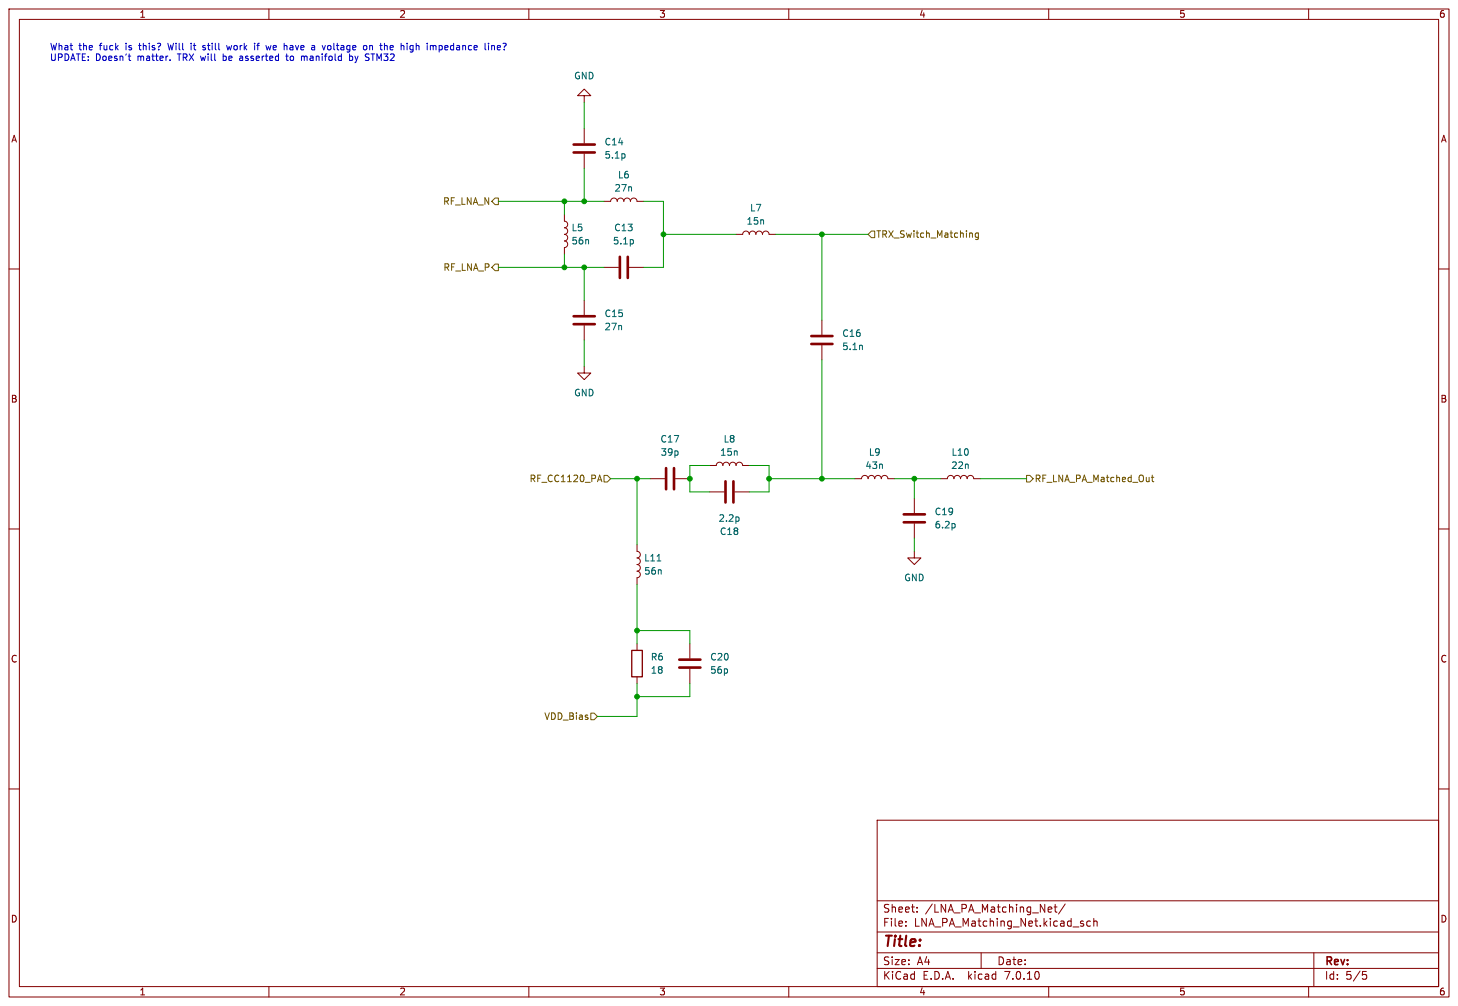
[picture p41: page 5]

Id: 5/5 Title: File: LNA_PA_Matching_Net.kicad_sch Sheet: /LNA_PA_Matching_Net/
