Lifearafter/CASE/Schematics/Flight_Computer/CUBESAT/CUBESAT.kicad_pcb

## KiCad design Schematics/Flight_Computer/CUBESAT/CUBESAT.kicad_pcb (2024-03-28)

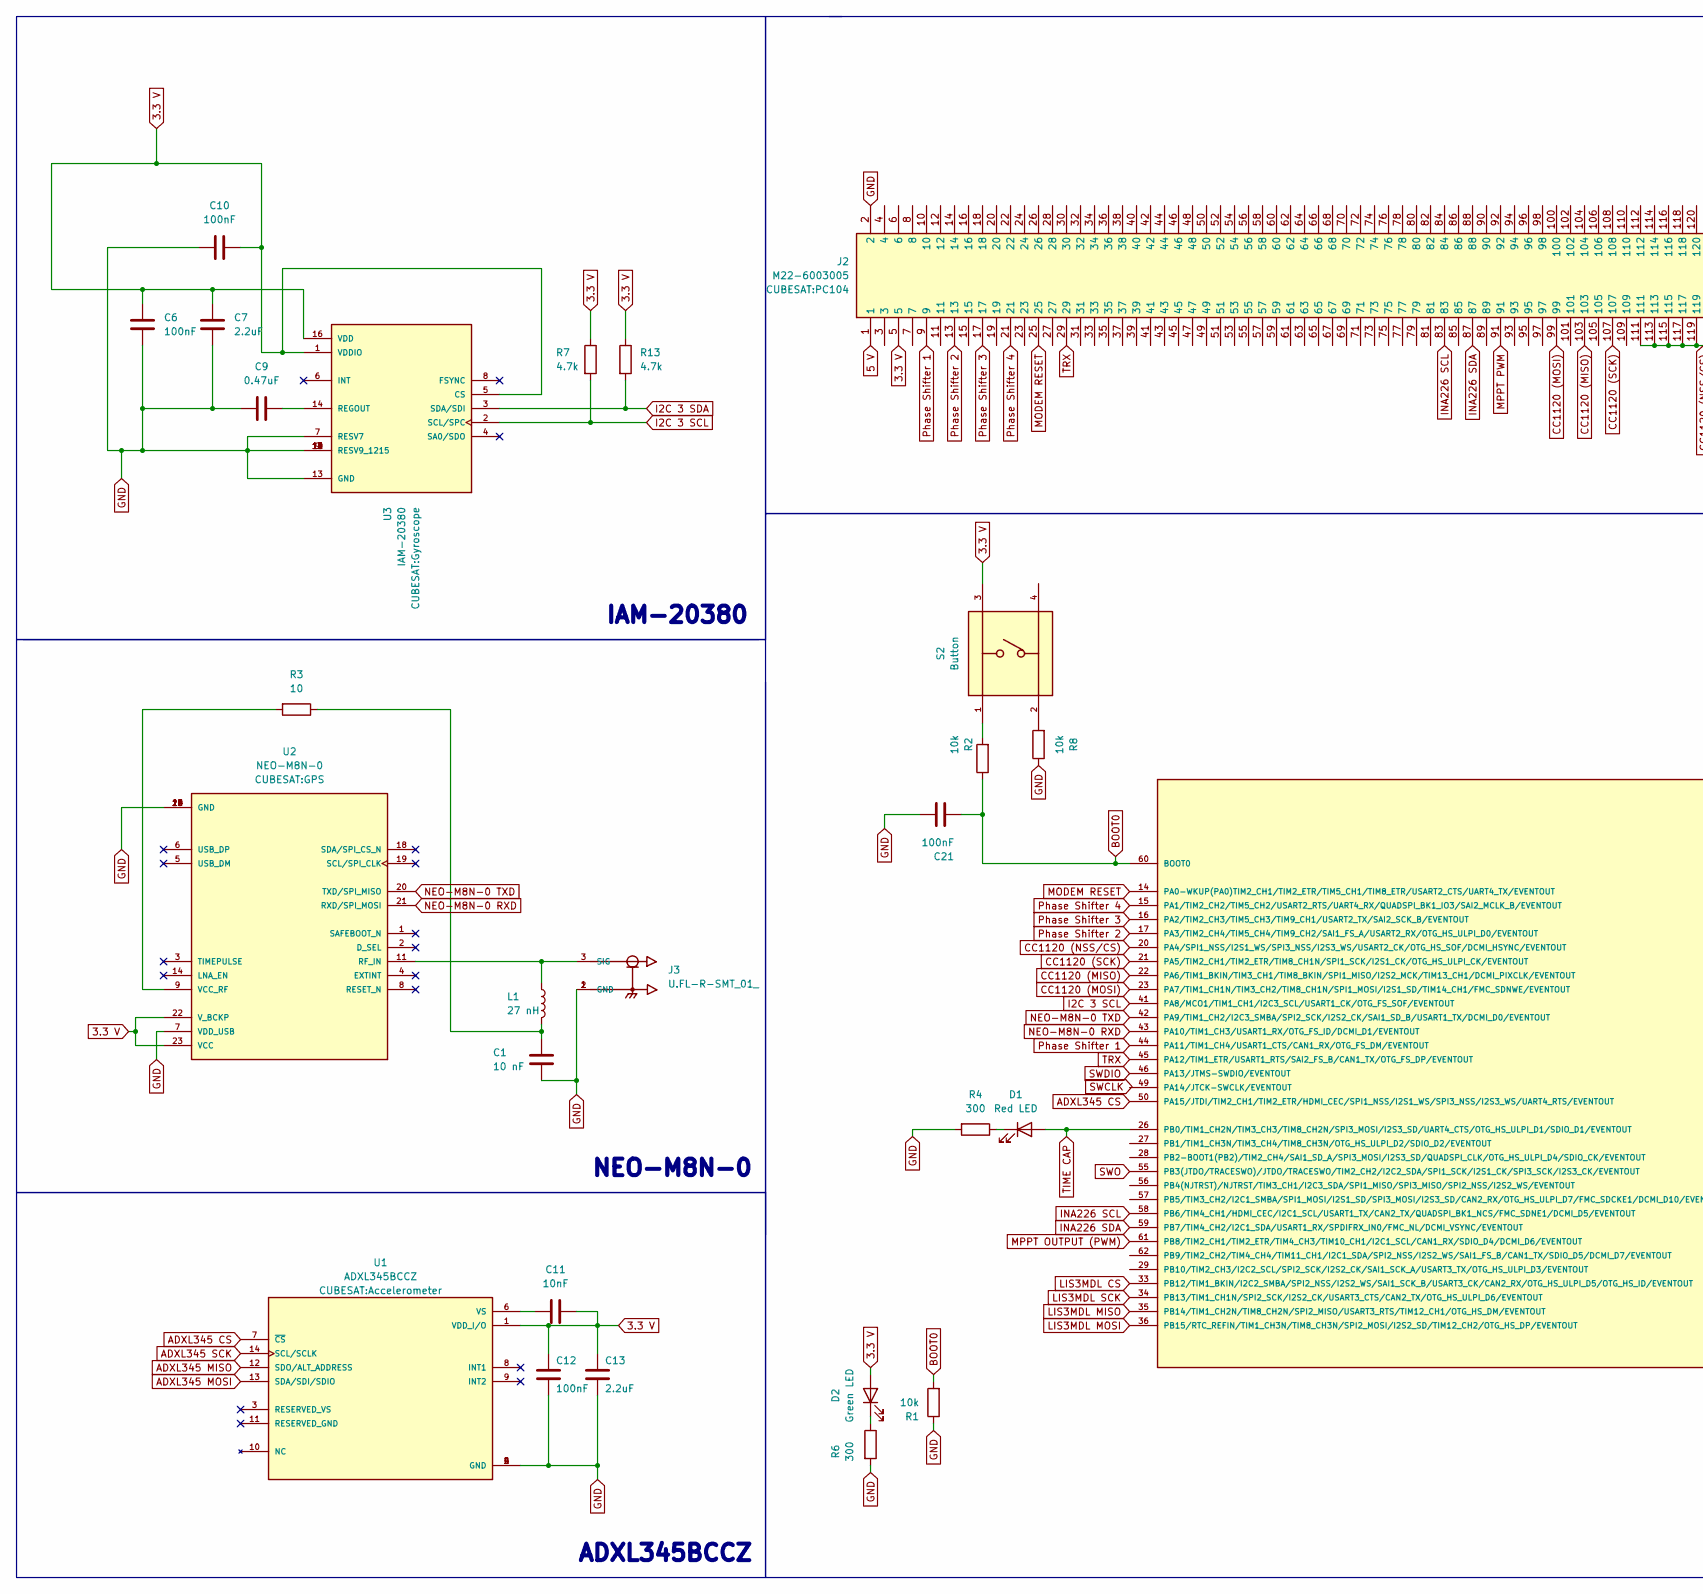
[picture p42: schematic CUBESAT.kicad_sch, part in row 1, column 1]

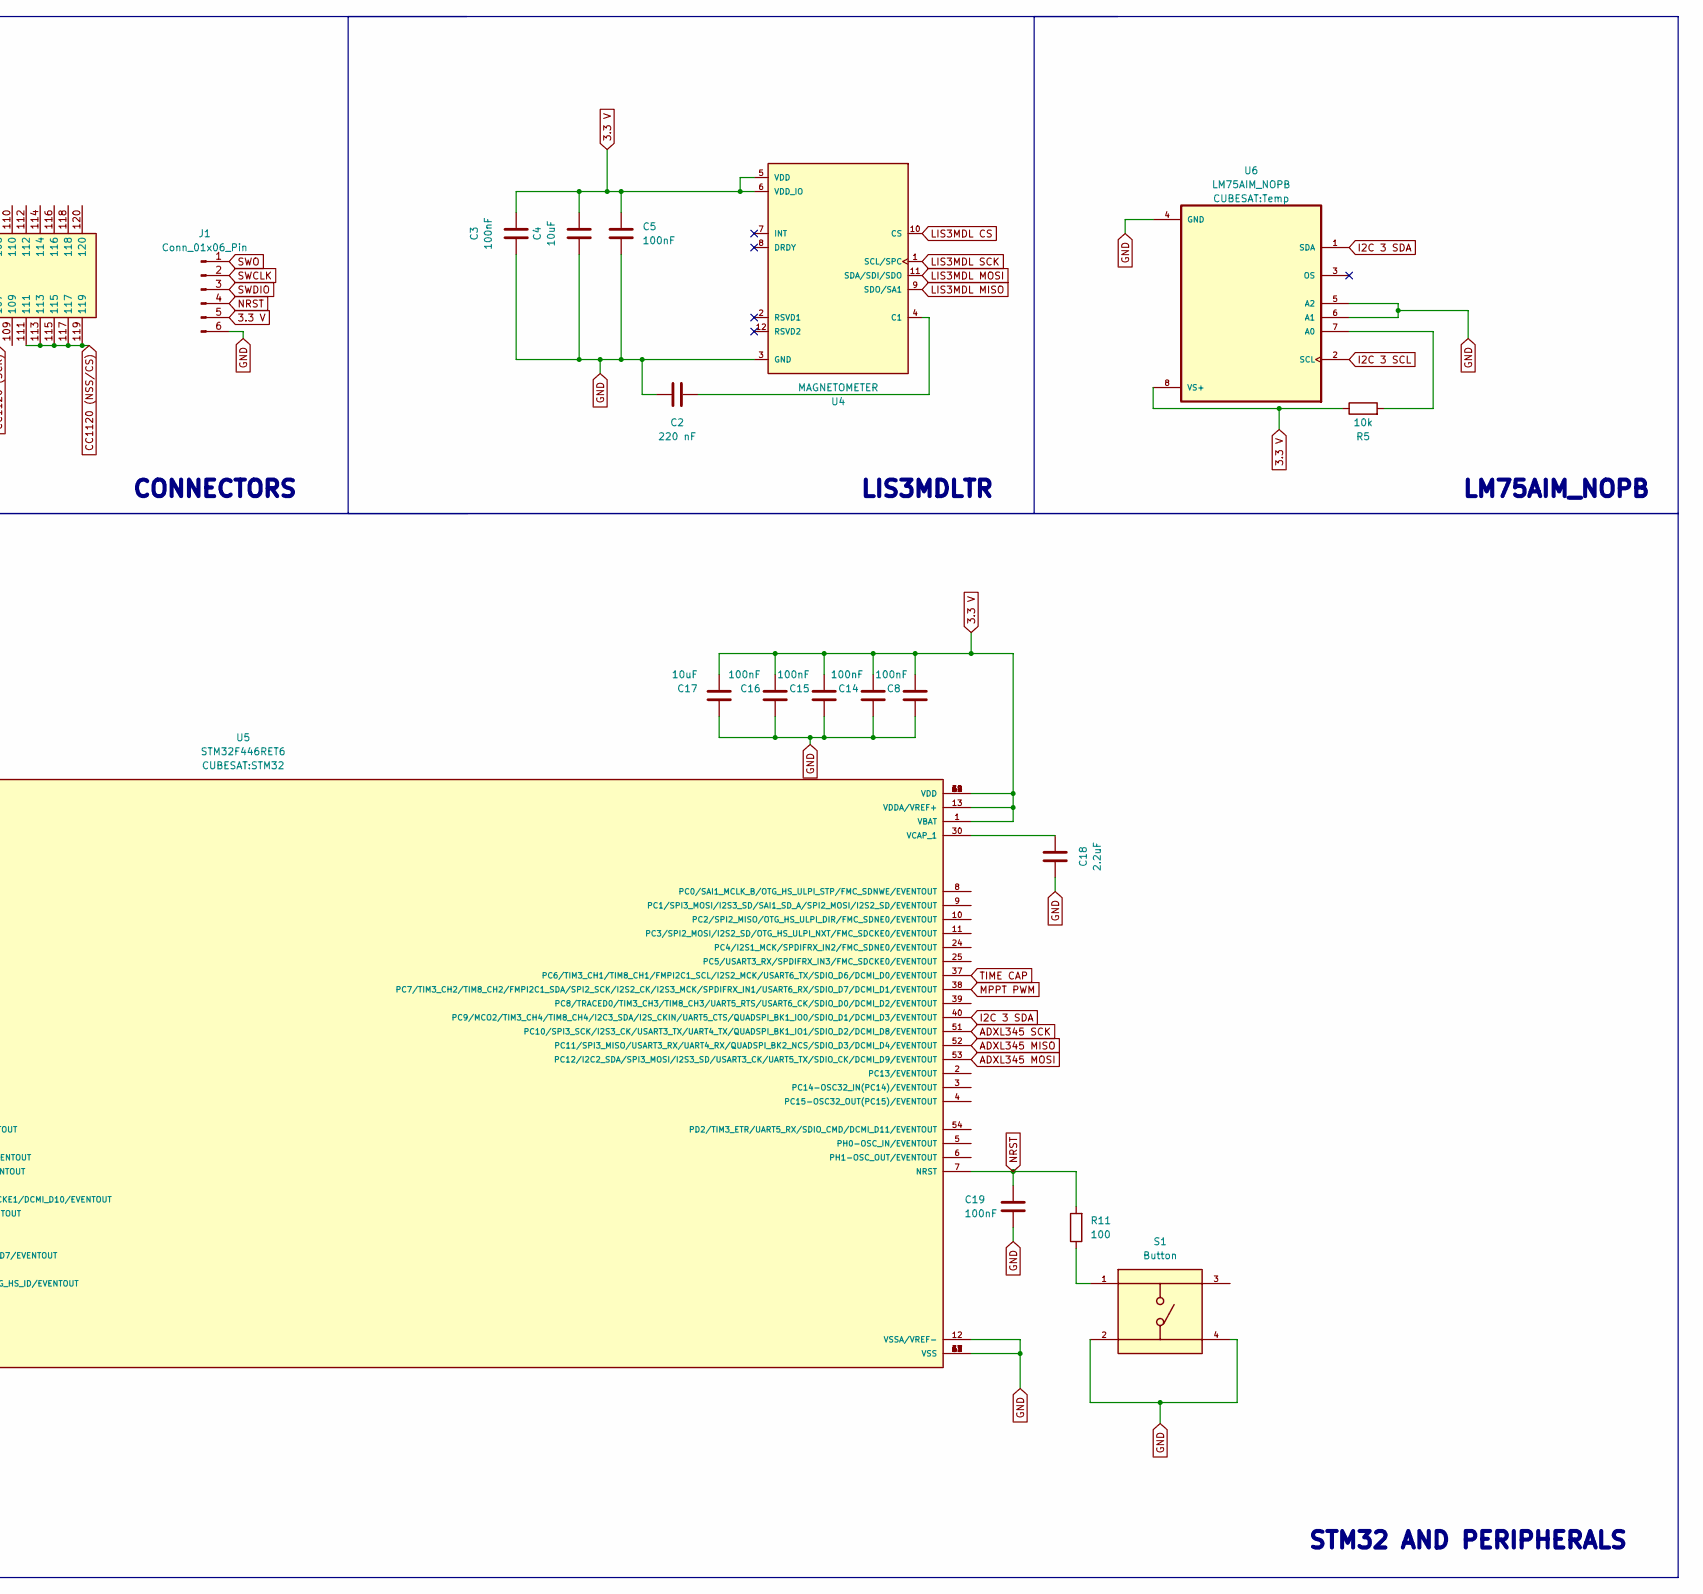
[picture p43: schematic CUBESAT.kicad_sch, part in row 1, column 2]

Parts:
C1: 10 nF; Capacitor10nf
C2: 220 nF; Capacitor220nf
C3, C5, C6, C8, C10, C12, C14, C15, C16, C19, C21: 100nF; Capacitor100nf
C4, C17: 10uF; Capacitor10uf
C7, C13, C18: 2.2uF; Capacitor2-2uf
C9: 0.47uF; Capacitor0-47uf
C11: 10nF; Capacitor10nf
D1: Red LED
D2: Green LED
J1: Conn_01x06_Pin; 6 Pin Connector
J2: M22-6003005; PC104; Manufacturer_Part_Number M22-6003005
J3: U.FL-R-SMT_01_; UFL
L1: 27 nH; Inductor27nH
R1, R2, R5, R8: 10k; Resistor10kO
R3: 10; Resistor10O
R4, R6: 300; Resistor300O
R7, R13: 4.7k; Resistor4.7kO
R11: 100; Reistor100O
S1, S2: Button
U1: ADXL345BCCZ; Accelerometer; PARTREV G
U2: NEO-M8N-0; GPS; PARTREV R04
U3: IAM-20380; Gyroscope
U4: MAGNETOMETER
U5: STM32F446RET6; STM32; PARTREV 6
U6: LM75AIM_NOPB; Temp

Connections:
3.3 V: C3.2, C4.2, C5.2, C6.1, C7.1, C8.1, C10.2, C11.2, C12.1, C13.1, C14.1, C15.1, C16.1, C17.1, D2.2 (A), J1.5, J2.5, R5.1, R7.1, R13.1, S2.3, U1.1 (VDD_I/O), U2.22 (V_BCKP), U2.23 (VCC), U3.1 (VDDIO), U3.5 (CS), U3.16 (VDD), U4.5 (VDD), U4.6 (VDD_IO), U5.1 (VBAT), U5.13 (VDDA/VREF+), U5.19 (VDD), U5.32 (VDD), U5.48 (VDD), U5.64 (VDD), U6.8 (VS+); also elsewhere on the board
5 V: J2.1
ADXL345 CS: U1.7 (~CS), U5.50 (PA15/JTDI/TIM2_CH1/TIM2_ETR/HDMI_CEC/SP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)
ADXL345 MISO: U1.12 (SDO/ALT_ADDRESS), U5.52 (PC11/SPI3_MISO/USART3_RX/UART4_RX/QUADS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)
ADXL345 MOSI: U1.13 (SDA/SDI/SDIO), U5.53 (PC12/I2C2_SDA/SPI3_MOSI/I2S3_SD/USART3_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)
ADXL345 SCK: U1.14 (SCL/SCLK), U5.51 (PC10/SPI3_SCK/I2S3_CK/USART3_TX/UART4_T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)
BOOT0: C21.2, R1.2, R2.1, U5.60 (BOOT0)
CC1120 (MISO): J2.103, U5.22 (PA6/TIM1_BKIN/TIM3_CH1/TIM8_BKIN/SPI1_M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)
CC1120 (MOSI): J2.99, U5.23 (PA7/TIM1_CH1N/TIM3_CH2/TIM8_CH1N/SPI1_M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)
CC1120 (NSS/CS): J2.111, J2.113, J2.115, J2.117, J2.119, U5.20 (PA4/SPI1_NSS/I2S1_WS/SPI3_NSS/I2S3_WS/U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)
CC1120 (SCK): J2.107, U5.21 (PA5/TIM2_CH1/TIM2_ETR/TIM8_CH1N/SPI1_SC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)
GND: C1.2, C2.1, C3.1, C4.1, C5.1, C6.2, C7.2, C8.2, C9.2, C10.1, C12.2, C13.2, C14.2, C15.2, C16.2, C17.2, C18.1, C19.2, C21.1, J1.6, J2.2, J3.1 (GND), J3.2 (GND), R1.1, R4.2, R6.2, R8.1, S1.2, S1.4, U1.2 (GND), U1.4 (GND), U1.5 (GND), U2.7 (VDD_USB), U2.10 (GND), U2.12 (GND), U2.13 (GND), U2.24 (GND), U3.7 (RESV7), U3.9 (RESV9_1215), U3.10 (RESV9_1215), U3.11 (RESV9_1215), U3.12 (RESV9_1215), U3.13 (GND), U3.15 (RESV9_1215), U4.3 (GND), U5.12 (VSSA/VREF-), U5.18 (VSS), U5.31 (VSS), U5.47 (VSS), U5.63 (VSS), U6.4 (GND), U6.5 (A2), U6.6 (A1)
I2C 3 SCL: R7.2, U3.2 (SCL/SPC), U5.41 (PA8/MCO1/TIM1_CH1/I2C3_SCL/USART1_CK/OT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), U6.2 (SCL); also elsewhere on the board
I2C 3 SDA: R13.2, U3.3 (SDA/SDI), U5.40 (PC9/MCO2/TIM3_CH4/TIM8_CH4/I2C3_SDA/I2S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), U6.1 (SDA)
INA226 SCL: J2.83, U5.58 (PB6/TIM4_CH1/HDMI_CEC/I2C1_SCL/USART1_T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)
INA226 SDA: J2.87, U5.59 (PB7/TIM4_CH2/I2C1_SDA/USART1_RX/SPDIFRX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)
LIS3MDL CS: U4.10 (CS), U5.33 (PB12/TIM1_BKIN/I2C2_SMBA/SPI2_NSS/I2S2_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)
LIS3MDL MISO: U4.9 (SDO/SA1), U5.35 (PB14/TIM1_CH2N/TIM8_CH2N/SPI2_MISO/USAR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)
LIS3MDL MOSI: U4.11 (SDA/SDI/SDO), U5.36 (PB15/RTC_REFIN/TIM1_CH3N/TIM8_CH3N/SPI2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)
LIS3MDL SCK: U4.1 (SCL/SPC), U5.34 (PB13/TIM1_CH1N/SPI2_SCK/I2S2_CK/USART3_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)
MODEM RESET: J2.25, U5.14 (PA0-WKUP(PA0)TIM2_CH1/TIM2_ETR/TIM5_CH1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)
MPPT OUTPUT (PWM): U5.61 (PB8/TIM2_CH1/TIM2_ETR/TIM4_CH3/TIM10_CH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)
MPPT PWM: J2.91, U5.38 (PC7/TIM3_CH2/TIM8_CH2/FMPI2C1_SDA/SPI2_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)
NEO-M8N-0 RXD: U2.21 (RXD/SPI_MOSI), U5.43 (PA10/TIM1_CH3/USART1_RX/OTG_FS_ID/DCMI_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)
NEO-M8N-0 TXD: U2.20 (TXD/SPI_MISO), U5.42 (PA9/TIM1_CH2/I2C3_SMBA/SPI2_SCK/I2S2_CK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)
NRST: C19.1, J1.4, R11.2, U5.7 (NRST)
unnamed: C1.1, L1.2, R3.1
unnamed: D1.1 (K), R4.1
unnamed: D2.1 (K), R6.1
unnamed: J3.3 (SIG), L1.1, U2.11 (RF_IN)
unnamed: R2.2, S2.1
unnamed: R8.2, S2.2
unnamed: R11.1, S1.1
unnamed: C11.1, U1.6 (VS)
unnamed: R3.2, U2.9 (VCC_RF)
unnamed: C9.1, U3.14 (REGOUT)
unnamed: C2.2, U4.4 (C1)
unnamed: C18.2, U5.30 (VCAP_1)
unnamed: R5.2, U6.7 (A0)
Phase Shifter 1: J2.9, U5.44 (PA11/TIM1_CH4/USART1_CTS/CAN1_RX/OTG_FS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)
Phase Shifter 2: J2.13, U5.17 (PA3/TIM2_CH4/TIM5_CH4/TIM9_CH2/SAI1_FS_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)
Phase Shifter 3: J2.17, U5.16 (PA2/TIM2_CH3/TIM5_CH3/TIM9_CH1/USART2_T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)
Phase Shifter 4: J2.21, U5.15 (PA1/TIM2_CH2/TIM5_CH2/USART2_RTS/UART4_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)
SWCLK: J1.2
SWDIO: J1.3, U5.46 (PA13/JTMS-SWDIO/EVENTOUT)
SWO: J1.1, U5.55 (PB3(JTDO/TRACESWO)/JTDO/TRACESWO/TIM2_C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)
TIME CAP: D1.2 (A), U5.26 (PB0/TIM1_CH2N/TIM3_CH3/TIM8_CH2N/SPI3_M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), U5.37 (PC6/TIM3_CH1/TIM8_CH1/FMPI2C1_SCL/I2S2_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)
TRX: J2.29, U5.45 (PA12/TIM1_ETR/USART1_RTS/SAI2_FS_B/CAN1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)

Notes on the sheet:
ADXL345BCCZ
STM32 AND PERIPHERALS
IAM-20380
LIS3MDLTR
CONNECTORS
LM75AIM_NOPB
NEO-M8N-0

Board: 2 copper layers, 46 parts (0 on the bottom side), 45 nets, no tracks yet.

Other parts of the board:
R10: Resistor4.7kO
R12: 4.7k; Resistor4.7kO

Their connections:
3.3 V: R10.2, R12.2; also elsewhere on the board
I2C 3 SCL: R10.1, R12.1; also elsewhere on the board
