Lifearafter/CASE/Schematics/Power_System/Power_System.kicad_pcb

## KiCad design Schematics/Power_System/Power_System.kicad_pcb (2024-03-26)

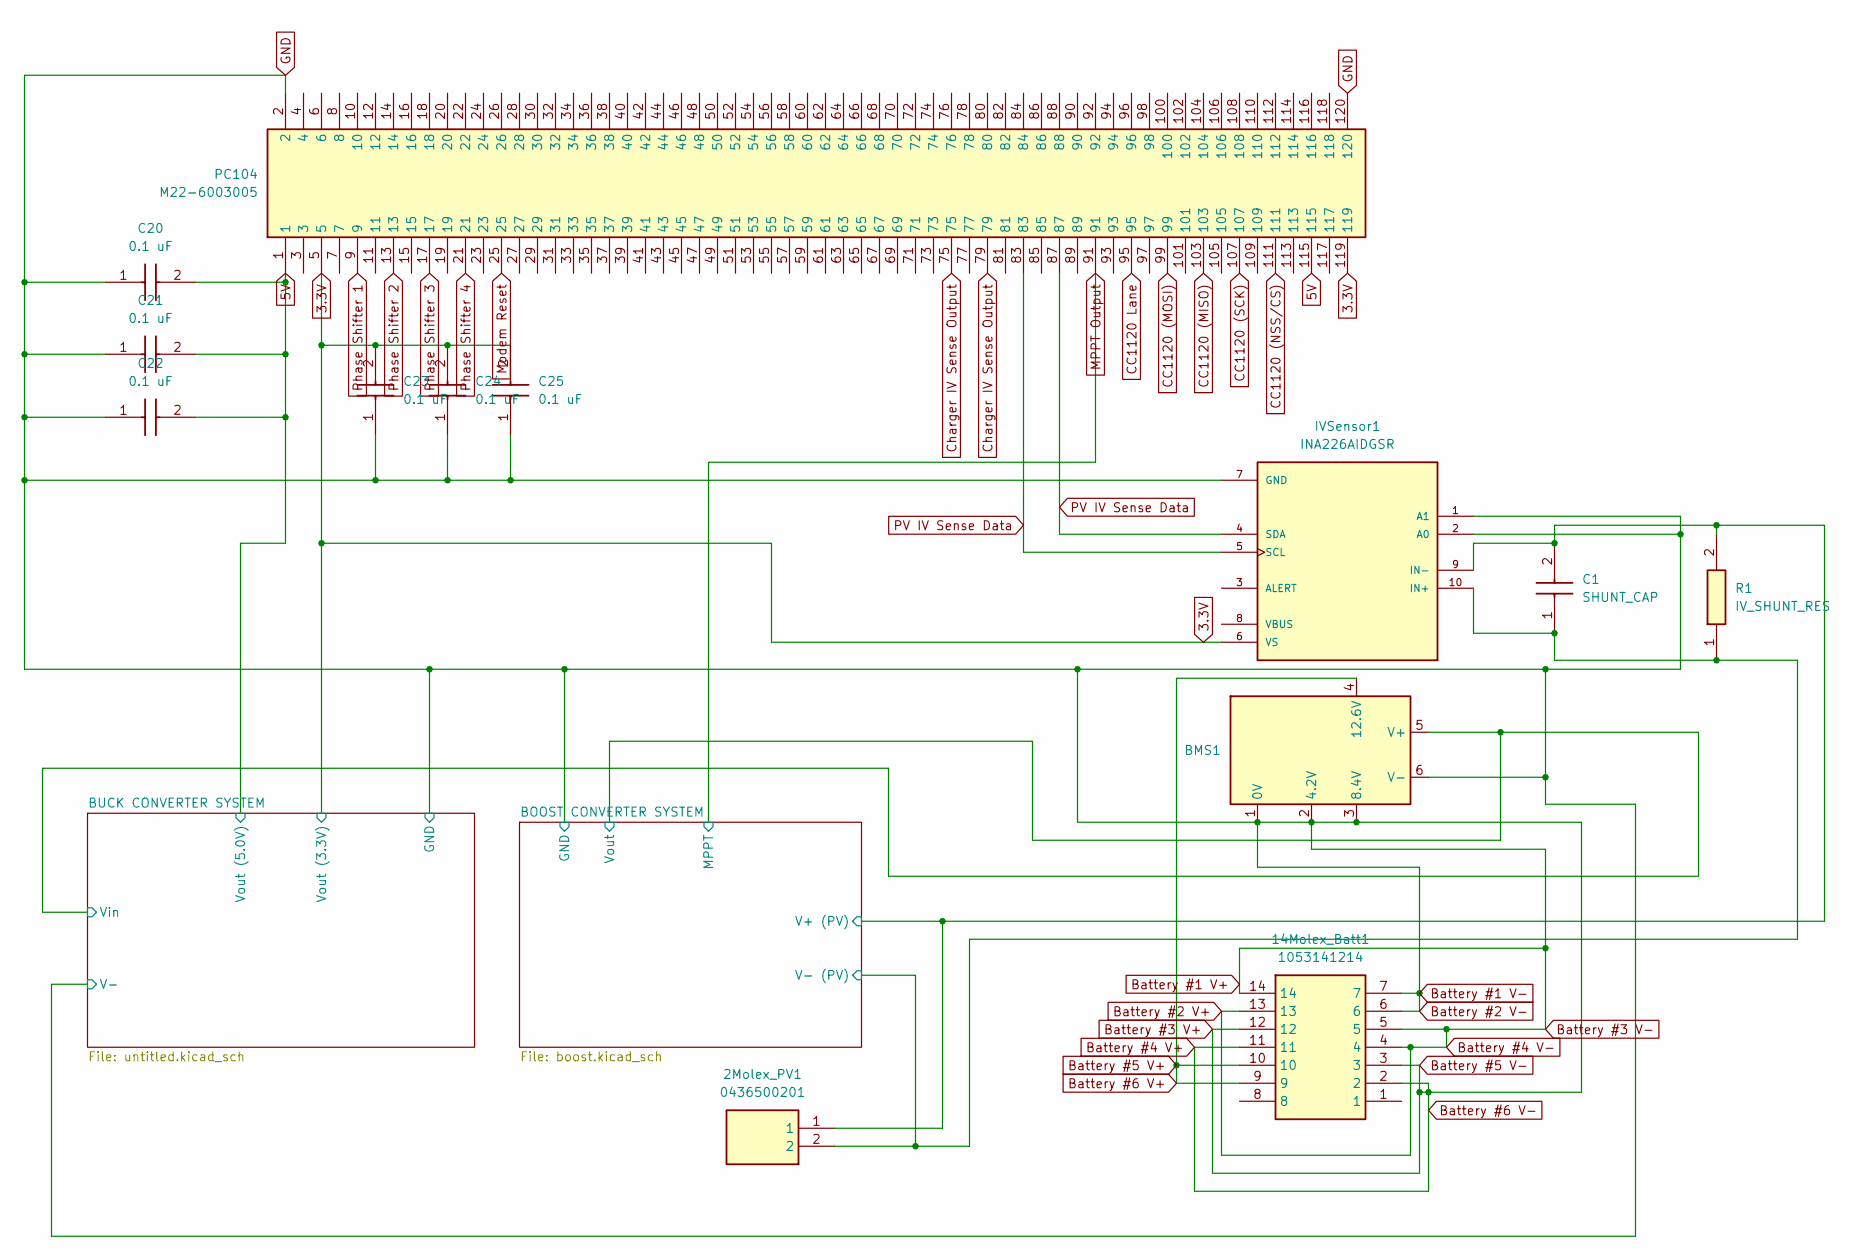
[picture p45: schematic Power_System.kicad_sch]

Parts:
2Molex_PV1: 0436500201; Manufacturer_Part_Number 0436500201; Mouser Part Number N/A
14Molex_Batt1: 1053141214; 105314YY14; Manufacturer_Part_Number 1053141214
BMS1: BMS
C1: SHUNT_CAP; C0805; Manufacturer_Part_Number C0805C102F5GACAUTO; Mouser Part Number 80-C0805C102F5GAUTO
C20, C21, C22, C23, C24, C25: 0.1 uF; Manufacturer_Part_Number C0603C104K1RACAUTO; Mouser Part Number 80-C0603C104K1RAUTO
IVSensor1: INA226AIDGSR; Powcur
PC104: M22-6003005; PC104; Manufacturer_Part_Number M22-6003005
R1: IV_SHUNT_RES; RESM11670X254N; Manufacturer_Part_Number WSR21R000FEA; Mouser Part Number 71-WSR21R000FEA

Connections:
3.3V: C23.2, C24.2, C25.2, IVSensor1.6 (VS), PC104.5, PC104.119; also elsewhere on the board
5V: C20.2, C21.2, C22.2, PC104.1, PC104.115; also elsewhere on the board
/BOOST CONVERTER SYSTEM/V+ (PV): 2Molex_PV1.1, C1.2, IVSensor1.9 (IN-), R1.2; also elsewhere on the board
/BOOST CONVERTER SYSTEM/Vout: BMS1.5 (V+); also elsewhere on the board
Battery #1 V+: 2Molex_PV1.2, 14Molex_Batt1.2, 14Molex_Batt1.3, 14Molex_Batt1.4, 14Molex_Batt1.5, 14Molex_Batt1.6, 14Molex_Batt1.7, 14Molex_Batt1.11, 14Molex_Batt1.12, 14Molex_Batt1.13, 14Molex_Batt1.14, BMS1.1 (0V), BMS1.2 (4.2V), BMS1.3 (8.4V), BMS1.6 (V-), C1.1, C20.1, C21.1, C22.1, C23.1, C24.1, C25.1, IVSensor1.1 (A1), IVSensor1.2 (A0), IVSensor1.7 (GND), IVSensor1.10 (IN+), PC104.2, PC104.120, R1.1; also elsewhere on the board
Battery #5 V+: 14Molex_Batt1.9, 14Molex_Batt1.10, BMS1.4 (12.6V)
CC1120 (MISO): PC104.103
CC1120 (MOSI): PC104.99
CC1120 (NSS/CS): PC104.111
CC1120 (SCK): PC104.107
CC1120 Lane: PC104.95
Charger IV Sense Output: PC104.75, PC104.79
MPPT Output: PC104.91; also elsewhere on the board
Modem Reset: PC104.25
PV IV Sense Data: IVSensor1.4 (SDA), IVSensor1.5 (SCL), PC104.83, PC104.87
Phase Shifter 1: PC104.9
Phase Shifter 2: PC104.13
Phase Shifter 3: PC104.17
Phase Shifter 4: PC104.21

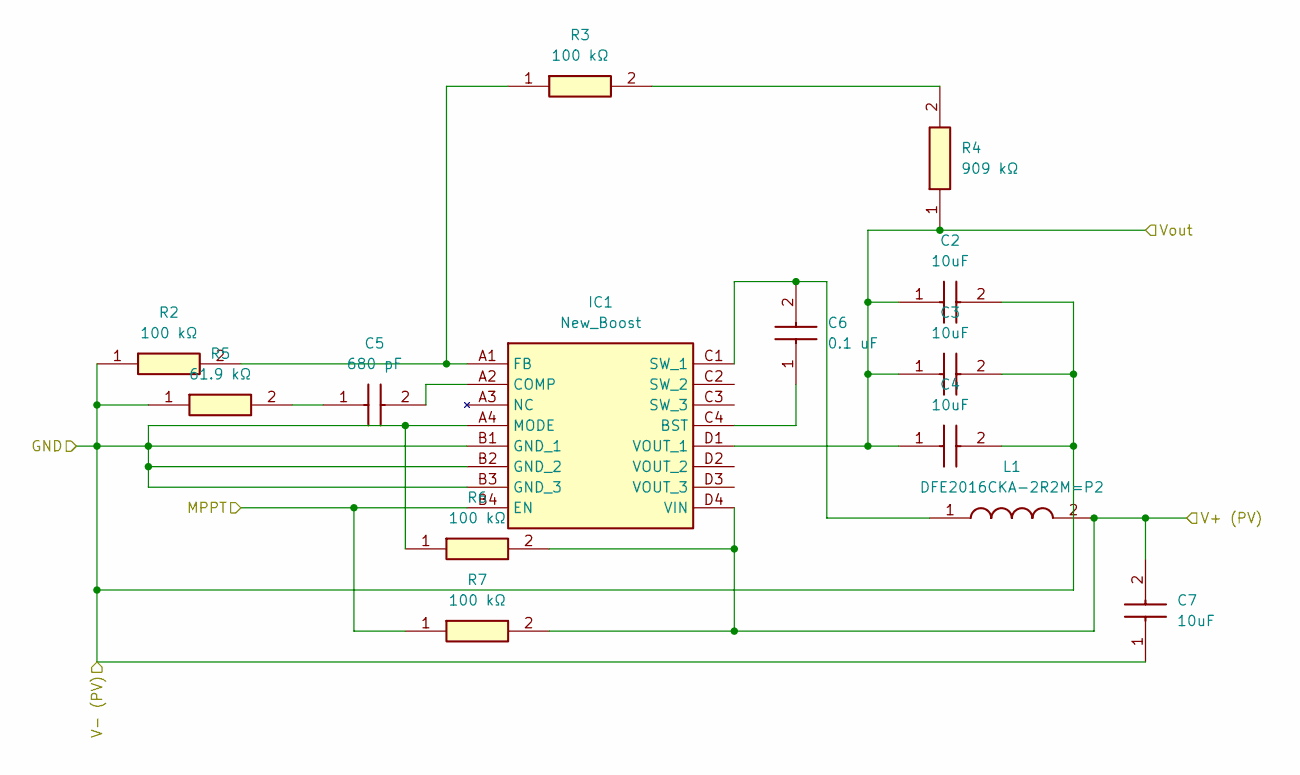
[picture p46: schematic boost.kicad_sch]

Parts:
C2, C3, C4, C7: 10uF; Manufacturer_Part_Number GRM188R61E106KA73D; Mouser Part Number 81-GRM188R61E106KA3D
C5: 680 pF; Manufacturer_Part_Number GCM1555C1H681FA16D; Mouser Part Number 81-GCM1555C1H681FA6D
C6: 0.1 uF; Manufacturer_Part_Number C0603C104K1RACAUTO; Mouser Part Number 80-C0603C104K1RAUTO
IC1: New_Boost; Manufacturer_Part_Number TPS61372YKBT; Mouser Part Number 595-TPS61372YKBT
L1: DFE2016CKA-2R2M=P2; DFE2016CKA1R0MP2; Manufacturer_Part_Number DFE2016CKA-2R2M=P2; Mouser Part Number 81-DFE2016CKA2R2M=P2
R2, R3, R6, R7: 100 kΩ; RESC1608X55N; Manufacturer_Part_Number MCT0603MG1003BP500; Mouser Part Number 594-MCT0603MG1003BP5
R4: 909 kΩ; Manufacturer_Part_Number RC0402FR-07909KL; Mouser Part Number 603-RC0402FR-07909KL
R5: 61.9 kΩ; Manufacturer_Part_Number ERA-3VEB6192V

Connections:
/BOOST CONVERTER SYSTEM/V+ (PV): C7.2, IC1.D4 (VIN), L1.2, R6.2, R7.2; also elsewhere on the board
/BOOST CONVERTER SYSTEM/Vout: C2.1, C3.1, C4.1, IC1.D1 (VOUT_1), R4.1; also elsewhere on the board
Battery #1 V+: C2.2, C3.2, C4.2, C7.1, IC1.A4 (MODE), IC1.B1 (GND_1), IC1.B2 (GND_2), IC1.B3 (GND_3), R2.1, R5.1, R6.1; also elsewhere on the board
MPPT Output: IC1.B4 (EN), R7.1; also elsewhere on the board
unnamed: C5.1, R5.2
unnamed: C6.1, IC1.C4 (BST)
unnamed: C5.2, IC1.A2 (COMP)
unnamed: IC1.A1 (FB), R2.2, R3.1
unnamed: C6.2, IC1.C1 (SW_1), L1.1
unnamed: R3.2, R4.2

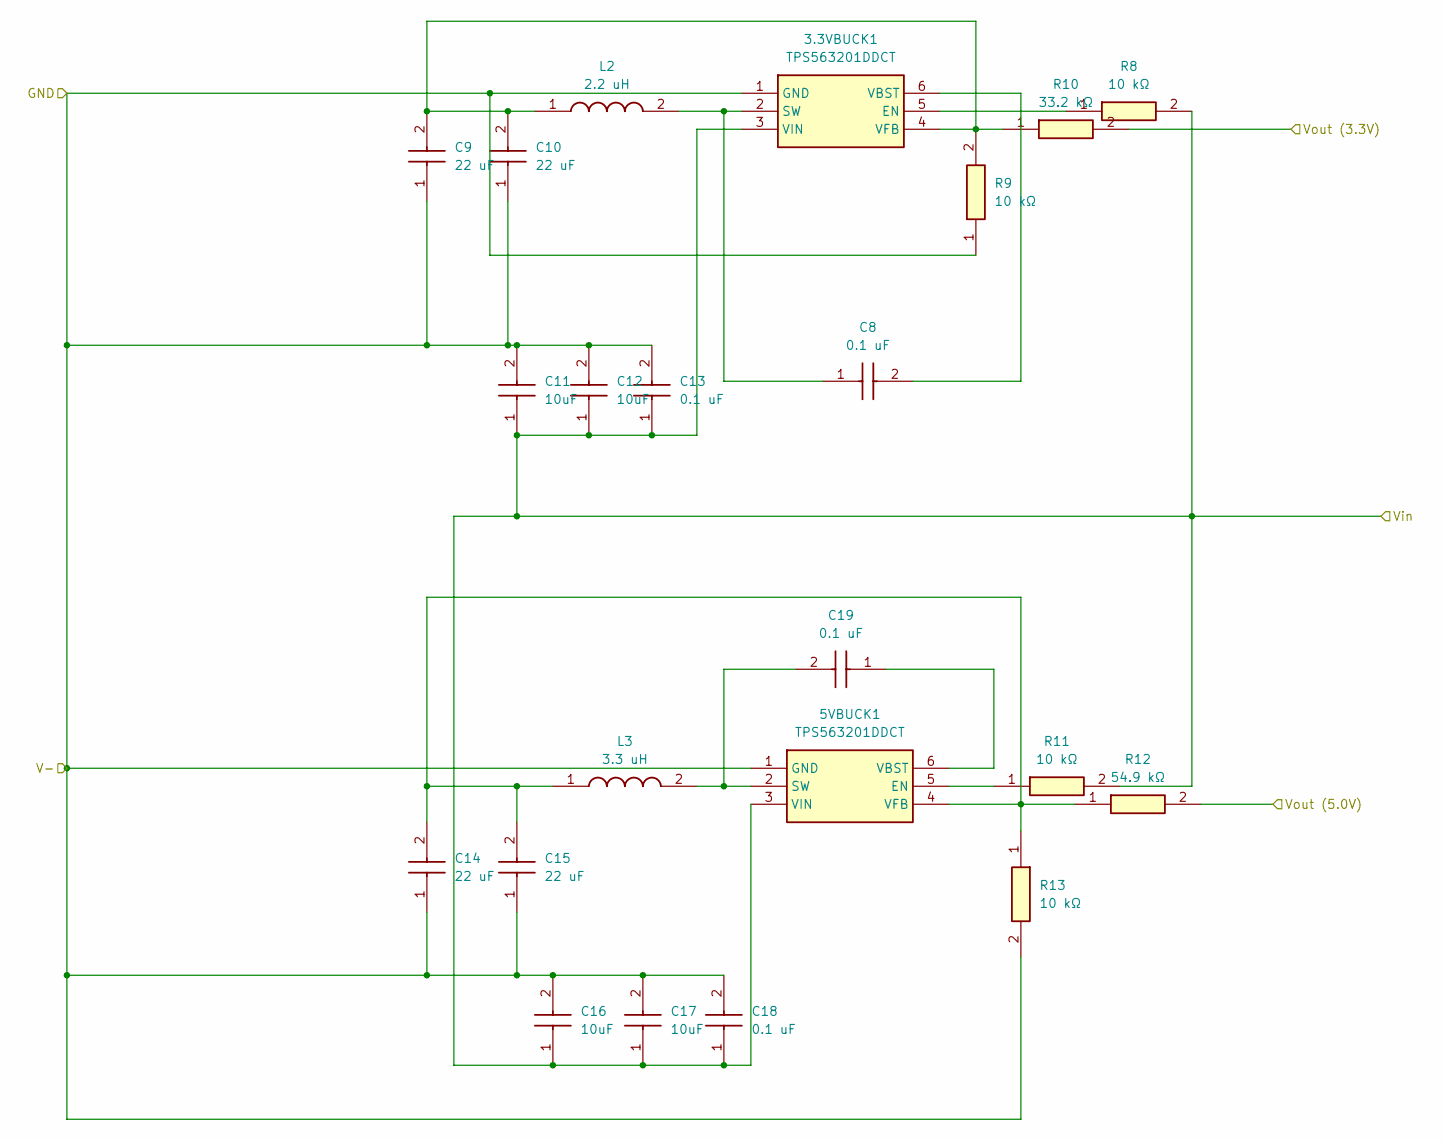
[picture p47: schematic untitled.kicad_sch]

Parts:
3.3VBUCK1, 5VBUCK1: TPS563201DDCT; SOT95P280X110-6N; Manufacturer_Part_Number TPS563201DDCT; Mouser Part Number 595-TPS563201DDCT
C8, C13, C18, C19: 0.1 uF; Manufacturer_Part_Number C0603C104K1RACAUTO; Mouser Part Number 80-C0603C104K1RAUTO
C9, C10, C14, C15: 22 uF; CAPC3216X180N; Manufacturer_Part_Number C3216X5R1E226M160AB; Mouser Part Number 810-C3216X5R1E226M
C11, C12, C16, C17: 10uF; Manufacturer_Part_Number GRM188R61E106KA73D; Mouser Part Number 81-GRM188R61E106KA3D
L2: 2.2 uH; DFE2016CKA1R0MP2; Manufacturer_Part_Number DFE2016CKA-2R2M=P2; Mouser Part Number 81-DFE2016CKA2R2M=P2
L3: 3.3 uH; INDC2520X120N; Manufacturer_Part_Number TFM252012ALVA3R3MTAA; Mouser Part Number 810-TFM252012ALVA3R3
R8, R9, R11, R13: 10 kΩ; Manufacturer_Part_Number ERJ-1GJF1002C; Mouser Part Number 667-ERJ-1GJF1002C
R10: 33.2 kΩ; 33.2 kO; Manufacturer_Part_Number ERA-2AEB3322X; Mouser Part Number 667-ERA-2AEB3322X
R12: 54.9 kΩ; Manufacturer_Part_Number ERJ-UP3F5492V

Connections:
3.3V: R10.2; also elsewhere on the board
5V: R12.2; also elsewhere on the board
/BOOST CONVERTER SYSTEM/Vout: 3.3VBUCK1.3 (VIN), 5VBUCK1.3 (VIN), C11.1, C12.1, C13.1, C16.1, C17.1, C18.1, R8.2, R11.2; also elsewhere on the board
Battery #1 V+: 3.3VBUCK1.1 (GND), 5VBUCK1.1 (GND), C9.1, C10.1, C11.2, C12.2, C13.2, C14.1, C15.1, C16.2, C17.2, C18.2, R9.1, R13.2; also elsewhere on the board
unnamed: 3.3VBUCK1.5 (EN), R8.1
unnamed: 3.3VBUCK1.2 (SW), C8.1, L2.2
unnamed: 3.3VBUCK1.6 (VBST), C8.2
unnamed: 3.3VBUCK1.4 (VFB), C9.2, C10.2, L2.1, R9.2, R10.1
unnamed: 5VBUCK1.5 (EN), R11.1
unnamed: 5VBUCK1.2 (SW), C19.2, L3.2
unnamed: 5VBUCK1.6 (VBST), C19.1
unnamed: 5VBUCK1.4 (VFB), C14.2, C15.2, L3.1, R12.1, R13.1

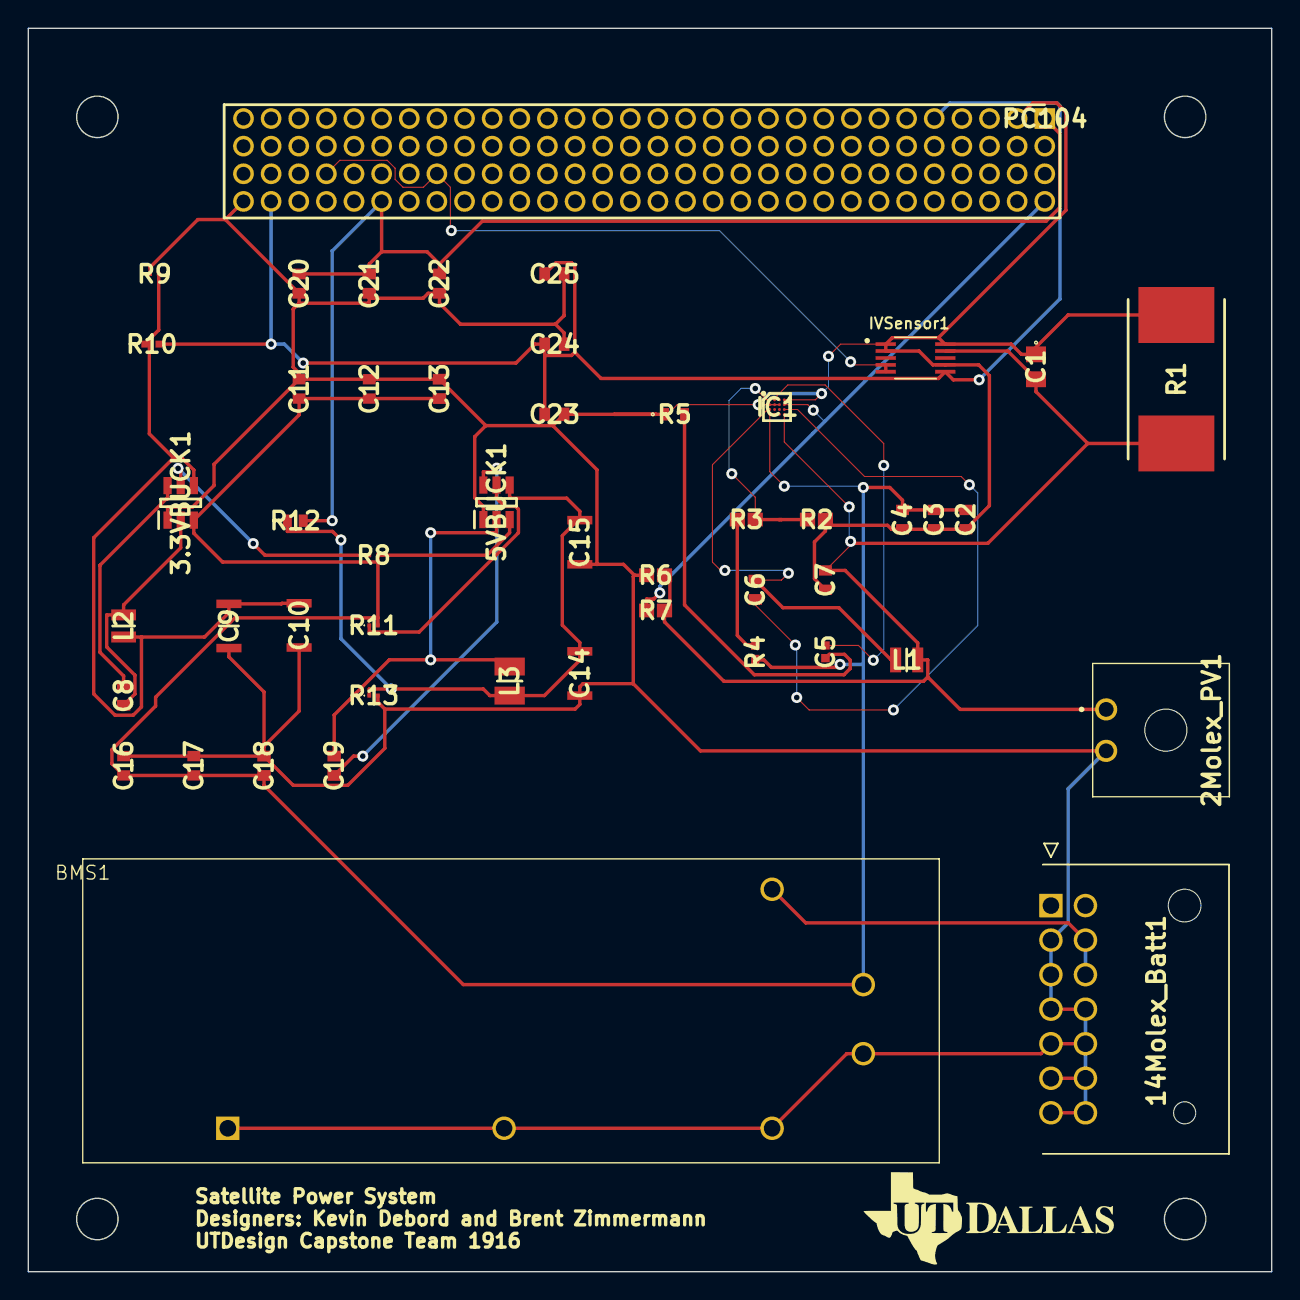
[picture p48: board Power_System.kicad_pcb from above]

Board: 2 copper layers, 90.0 x 90.0 mm, 49 parts (0 on the bottom side), 23 nets.
