Lifearafter/CASE/Drivers/Peripherals/Inc/INA226_Driver.h

#ifndef __INA226_DRIVER_H
#define __INA226_DRIVER_H

#include "stm32f4xx_hal.h"
#include "stm32f4xx_hal_i2c.h"
#include "gpio_mapping.h"
#include "error_handler.h"

// INA225 Address
#define INA226_ADDRESS 0x40 << 1 // A0 is connected to GND, A1 is connected to GND default

// INA226 registers
#define INA226_REG_CONFIG 0x00
#define INA226_REG_SHUNTVOLTAGE 0x01
#define INA226_REG_BUSVOLTAGE 0x02
#define INA226_REG_POWER 0x03
#define INA226_REG_CURRENT 0x04
#define INA226_REG_CALIBRATION 0x05
#define INA226_REG_MASKENABLE 0x06
#define INA226_REG_ALERTLIMIT 0x07
#define INA226_REG_MANUFACTURERID 0xFE
#define INA226_REG_DIEID 0xFF

// INA226 configuration register bits
#define INA226_CONFIG_RESET 0x8000
#define INA226_CONFIG_MASK_ENABLE 0x4000
#define INA226_CONFIG_ALERT_POLARITY 0x2000
#define INA226_CONFIG_ALERT_LATCH 0x1000
#define INA226_CONFIG_ALERT_QUEUE_1 0x0000
#define INA226_CONFIG_ALERT_QUEUE_2 0x0400
#define INA226_CONFIG_ALERT_QUEUE_4 0x0800
#define INA226_CONFIG_ALERT_QUEUE_8 0x0C00
#define INA226_CONFIG_AVG_1 0x0000
#define INA226_CONFIG_AVG_4 0x0200
#define INA226_CONFIG_AVG_16 0x0400
#define INA226_CONFIG_AVG_64 0x0600
#define INA226_CONFIG_AVG_128 0x0800
#define INA226_CONFIG_AVG_256 0x0A00
#define INA226_CONFIG_AVG_512 0x0C00
#define INA226_CONFIG_AVG_1024 0x0E00
#define INA226_CONFIG_VBUSCT_140US 0x0000
#define INA226_CONFIG_VBUSCT_204US 0x0040
#define INA226_CONFIG_VBUSCT_332US 0x0080
#define INA226_CONFIG_VBUSCT_588US 0x00C0
#define INA226_CONFIG_VBUSCT_1100US 0x0100
#define INA226_CONFIG_VBUSCT_2116US 0x0140
#define INA226_CONFIG_VBUSCT_4156US 0x0180
#define INA226_CONFIG_VBUSCT_8244US 0x01C0
#define INA226_CONFIG_VSHCT_140US 0x0000
#define INA226_CONFIG_VSHCT_204US 0x0008
#define INA226_CONFIG_VSHCT_332US 0x0010
#define INA226_CONFIG_VSHCT_588US 0x0018
#define INA226_CONFIG_VSHCT_1100US 0x0020
#define INA226_CONFIG_VSHCT_2116US 0x0028
#define INA226_CONFIG_VSHCT_4156US 0x0030
#define INA226_CONFIG_VSHCT_8244US 0x0038
#define INA226_CONFIG_MODE_POWERDOWN 0x0000
#define INA226_CONFIG_MODE_SHUNT_TRIG 0x0001
#define INA226_CONFIG_MODE_BUS_TRIG 0x0002
#define INA226_CONFIG_MODE_SHUNT_BUS_TRIG 0x0003
#define INA226_CONFIG_MODE_ADC_OFF 0x0004
#define INA226_CONFIG_MODE_SHUNT_CONT 0x0005
#define INA226_CONFIG_MODE_BUS_CONT 0x0006
#define INA226_CONFIG_MODE_SHUNT_BUS_CONT 0x0007

// INA260 Register
#define INA260_REG_CONFIG 0x00
#define INA260_REG_CURRENT 0x01
#define INA260_REG_BUSVOLTAGE 0x02
#define INA260_REG_POWER 0x03
#define INA260_REG_MASKENABLE 0x06

// INA260 configuration register bits
#define INA260_CONFIG_RESET 0x8000

// Macros
#define CURRENT_LSB 1.25         // 1.25mA/LSB
#define POWER_LSB 10             // 10mW/LSB
#define CALIBRATION_VALUE 0x2000 // 0x2000 is the default value for the calibration register
#define BUS_VOLTAGE_LSB 1.25     // 1.25mV/LSB

// Function prototypes
void INA226_Init(void);
HAL_StatusTypeDef INA226_present(void);
HAL_StatusTypeDef readBusVoltage(uint16_t *bus_voltage);
HAL_StatusTypeDef readCurrent(uint16_t *current);
HAL_StatusTypeDef readPower(uint16_t *power);

HAL_StatusTypeDef writeRegister(uint8_t register_address, uint16_t data);
HAL_StatusTypeDef configReset(void);

#endif
