Lifearafter/CASE/Drivers/Peripherals/Src/IAM20380_Driver.c

#include "IAM20380_Driver.h"

// Define SPI instance
struct SPI_Module spi;

void IAM20380_Init(void)
{
    // Initialize SPI instance
    // Code for SPI initialization goes here
}

HAL_StatusTypeDef IAM20380_ReadReg(uint8_t register_address, uint8_t *data, uint16_t size)
{
    // Function to read data from a register
    // Modify this function according to the SPI protocol of IAM20380
}

HAL_StatusTypeDef IAM20380_WriteReg(uint8_t register_address, uint8_t *data, uint16_t size)
{
    // Function to write data to a register
    // Modify this function according to the SPI protocol of IAM20380
}

void IAM20380_Config(void)
{
    // Function to configure IAM20380
    // Modify this function according to the configuration requirements of IAM20380
}

HAL_StatusTypeDef IAM20380_Check(void)
{
    // Function to check the presence of IAM20380
    // Modify this function according to the check method of IAM20380
}

void IAM20380_ReadGyro(int16_t *x, int16_t *y, int16_t *z)
{
    uint8_t data[6];
    if (IAM20380_ReadReg(0x0F, data, 6) != HAL_OK)
    {
        // Error handling
        return;
    }

    // Assuming the data format is consistent (x, y, z in consecutive registers)
    *x = (int16_t)(data[1] << 8 | data[0]);
    *y = (int16_t)(data[3] << 8 | data[2]);
    *z = (int16_t)(data[5] << 8 | data[4]);
}
