Lifearafter/CASE/App/Tasks/Src/vBlinkLD2.c

#include "vBlinkLD2.h"
#include <stdio.h>

/**
 * @brief LD2 blinking task
 * @param pvParameters not used
 * @retval None
 */
void vBlinkLD2(void *pvParameters)
{
    for (;;)
    {
        HAL_GPIO_TogglePin(LD2_GPIO_Port, LD2_Pin);
        vTaskDelay(100);
        printf("Hello World!\n");
    }
}
