Lifearafter/CASE/(commit log)

2024-01-19 feat: NeoM8n SPI driver
2024-01-19 feat: add the driver templates for INA226, and LM75A using I2C interfaces
2024-01-26 feat: updates NeoM8n drivers for uart, and INA226 drivers with new registers and config
2024-01-28 feat: add COM support over USART for printf to console
2024-02-08 feat: working LM75A driver over I2C with fixed address 0x48
    [COM_Driver.c, COM_Driver.h, LM75A_Driver.c, LM75A_Driver.h, vTelemetry.c]
2024-02-08 feat: add com support to print explicit char arrays
2024-02-12 feat: INA260 driver update
2024-02-15 feat: add NMEA parsing to NeoM8N drivers
2024-02-15 feat: add parsing and buffer capabilities to NEOM8N driver
2024-02-15 feat: add ADXL345 driver capabilities
2024-02-16 feat: create files for new sensors
2024-03-26 feat: new drivers for LIS3MDL and IAM20380
2024-03-26 feat: add all kicad schematics for the project, seperated by subsystem ie Flight, Power, Comms
    [AC0402JRNPO9BN390.stp, Accelerometer.step, Amplifier_Array.kicad_sch, B82496C3829J.stp, Button.step, C0201C560J3GACTU.stp, C0402C103K1RACAUTO.stp, C0603C200K8HACTU.stp]
2024-03-28 feat: New and updated FC
    [6 Pin Connector.step, Accelerometer.step, Button.step, CUBESAT.csv, CUBESAT.kicad_pcb, CUBESAT.kicad_sch, Capacitor0-47uf.step, Capacitor100nf.step]
2024-03-28 feat: cleaned up schematic for FC
    [CUBESAT.kicad_sch]
2024-03-28 feat: new updated sch for better readibility
    [CUBESAT.kicad_sch]
2024-03-28 updated pcb without traces or via's
    [CUBESAT.kicad_pcb]
